sarreola07/VENATOR/drone/wildlife/README.md

# drone/wildlife/ — the two wildlife cameras

Animal and human detection for field work. Two cameras that cover for each
other: the OAK-D-S2 sees in daylight and measures distance, the CSI camera sees
in the dark.

| Camera | Sensor | Role |
|---|---|---|
| **Camera 1** — OAK-D-S2 | IMX378 + 2× OV9282 | Daytime detection with stereo depth. Inference runs on its own VPU. |
| **Camera 2** — IMX219-160 IR-CUT | IMX219 on CAM0 | 160° FOV, colour by day, black and white at night, IR-sensitive. |

This is separate from [`../camera_publisher.py`](../README.md), the flight
person-tracker. That one stays on depthai 2.32 in
`~/oak_drone_project/depthai-env`; the wildlife code here uses depthai 3.10 in
`~/oak-venv`. The two APIs are incompatible, so keep the interpreters straight.

| File | What it is |
|---|---|
| `imx219_feed.py` | Camera 2. Live window or numpy frames, with day/night switching and the 180° invert. No OpenCV needed. |
| `ircut.py` | Day/night control of the IR-CUT optical filter over GPIO. |
| `imx219_camera.sh` | Launcher used by the desktop icon: `720p`, `1080p`, `day`, `night`, `snapshot`. Refuses to open a second capture. |
| `oak_camera.sh` | Launcher for camera 1: `detect`, `gui`, `info`, `test`, `images`, `classes`, `status`. Refuses to start if something else owns the OAK. |
| `oak_wildlife.py` | Camera 1. Spatial animal/person detection with a distance per hit; saves annotated evidence frames. Runs MegaDetector V6. |
| `tracking.py` | Per-object history from tracker ids: dwell, voted class, metric displacement. The detector had no memory before this. |
| `classes.py` | What gets reported and the confidence each class needs. One table shared by the live detector, the offline harness and the GUI, so they cannot disagree. |
| `gui_server.py` | Operator GUI for a phone, on `:8080`. The OAK encodes MJPEG itself and this relays the bytes undecoded — the Jetson has no hardware video encoder. See [../../docs/OPERATOR_GUI.md](../../docs/OPERATOR_GUI.md). |
| `gui_page.py` | The GUI's single page. Dark, red/amber, boxes drawn client-side on a canvas. |
| `vest.py` | The vest search: finds the person in the target colour and ignores everyone else. See [Vest search](#vest-search). |
| `vest_calibrate.py` | Teaches the vest search what the vests look like in this room. |
| `webcam_search.py` | The vest search on a Mac's webcam, with Apple's person detector and no depth. A proof of concept, not the flight path. |
| `oak_info.py` | Identifies the OAK, its fitted sensors and whether it has IR illumination. |
| `oak_test.py` | Proves the OAK streams colour and stereo depth. |
| `test_detector.py` | Runs the detector over image files, so you can check what it sees before flying it. |
| `setup_cam0.sh` | One-time device-tree overlay enable for CAM0. Needs sudo; dry-run by default. |
| `oak_daynight.py` | Live view that switches itself between colour and mono from what auto-exposure is doing. |
| `oak_night.py` | Mono-only night view (both sensors side by side, for comparison). |
| `lib_pid.sh` | Shared process lookup. `pgrep -f` alone matches shells that merely mention a script name. |
| `oak_ir_test.py` | Does this OAK see infrared? Locks exposure and compares all three sensors. |
| `checks/` | `check_camera.sh` (8-point camera health), `system_check.sh` (whole box, incl. the 7 W guard), `diagnose.sh` (GUI wrapper). |
| `config/` | Known-good boot config and checksums — see [Recovery](#recovery). |

## Everyday commands

Each camera has one executable; neither needs you to remember which interpreter
to use.

```bash
# camera 2 — CSI
./drone/wildlife/imx219_camera.sh            # feed, auto day/night
./drone/wildlife/imx219_camera.sh night      # force black and white
./drone/wildlife/imx219_camera.sh snapshot   # full-res still into ~/Pictures

# camera 1 — OAK-D
./drone/wildlife/oak_camera.sh               # detect, with distance
./drone/wildlife/oak_camera.sh gui           # operator GUI for a phone, :8080
./drone/wildlife/oak_camera.sh view          # live view, auto colour/mono
./drone/wildlife/oak_camera.sh day|night     # force one mode
./drone/wildlife/oak_camera.sh calibrate     # AE readings, to tune thresholds
./drone/wildlife/oak_camera.sh info          # what OAK is this?
./drone/wildlife/oak_camera.sh status        # who currently owns the device?
./drone/wildlife/oak_camera.sh images ~/Pictures/testset/   # test on photos

# health
./drone/wildlife/checks/check_camera.sh      # is camera 2 healthy?
./drone/wildlife/checks/system_check.sh      # is anything else wrong?
```

Desktop icons for both are installed by `bash deploy/install_shortcuts.sh`:
**Wildlife Camera (IMX219)** and **Wildlife Detector (OAK-D)**. Right-click
either for day/night, snapshot, device info and health actions.

The OAK allows exactly one host process, and the flight person-tracker wants it
too. `oak_camera.sh` checks first and tells you who has it, rather than failing
with a device error twenty seconds in.

## Day and night

| | Colour | ISP saturation | IR-CUT filter |
|---|---|---|---|
| **day** | normal colour | 1.0 | ON — blocks IR |
| **night** | black and white | 0.0 | OFF — IR passes |

Both are hardware paths. `saturation` is an `nvarguscamerasrc` property applied
inside the ISP, so greyscale is free — no GRAY8 conversion, no CPU
`videobalance`. The 180° invert is `nvvidconv flip-method=2`, which runs on the
VIC. Measured cost of all of it: **55 fps at 640×360**, slightly *faster* than
before the flip and metering branch were added.

Greyscale at night is not cosmetic. With the IR-CUT filter removed the Bayer
colour filters see infrared, producing a heavy magenta cast that carries no real
colour information. Dropping chroma gives a cleaner image that compresses better.

### Switching is on a clock, not on the image

`--daynight schedule` is the default: sunrise/sunset at `--lat`/`--lon`
(defaults to Austin), using −6° civil twilight. It cannot be fooled by
auto-exposure, headlights, or a camera pointed at the ground.

`--daynight auto` (metering the image) **does not work on this camera** and is
kept only for hand testing. Measured in a pitch-dark room:

```
meter mean = 101.5      night threshold was 40
```

Argus auto-exposure raises analog gain up to 10.6× until the scene averages to
a "correct" exposure, so mean luma sits near mid-grey however dark it really is.
No threshold separates day from night through AE — raising it above 101 would
just report night at midday.

### Night mode needs an IR light source

Removing the IR-CUT filter makes the sensor **able to see** infrared. It does
not **produce** infrared. In a dark room with no IR source, an IR-sensitive
camera sees exactly what a normal one does: nothing. Measured:

| Mode | mean luma | std dev | JPEG |
|---|---|---|---|
| day (colour) | 37.6 | 0.5 | 4 KB |
| night (B&W) | 36.6 | 0.5 | 4 KB |

Identical blank frames — a std of 0.5/255 is amplified sensor noise, not an
image. The Waveshare kit's **IR illuminator boards must be connected to the
3.3 V pads** on the camera PCB for night vision to mean anything. IR is
invisible; point a phone camera at them to confirm they are lit.

Those illuminators reach perhaps 5–10 m. That is fine for a fixed camera trap
and useless from a drone at altitude — see the thermal note in
[../../docs/WILDLIFE_CAMERA.md](../../docs/WILDLIFE_CAMERA.md).

### The IR-CUT filter needs one wire

The 22-pin CAM0 connector carries no spare GPIO, so the filter is switched from
the 40-pin header:

```
camera "IR-CUT" / IO pad  ->  40-pin BOARD pin 7
camera GND                ->  40-pin pin 6 (or 9/14/20/25/30/34/39)
```

3.3 V logic both ends. **Never drive that pad from a 5 V pin.** Without the wire
everything still runs — you get the colour/greyscale switch but not the optical
filter, and the feed prints one warning saying so.

The infrared **illuminator LEDs are not software-controllable at all**. They are
wired to the camera board's 3.3 V pads and lit whenever it has power; switching
them would need a MOSFET in that supply. IR is invisible — point a phone camera
at them to check.

## The 7 W budget is guarded, because it drifted once

`system_check.sh` verifies three separate things, not just the live mode:

| Check | Why |
|---|---|
| `nvpmodel` id == 1 | the mode right now |
| `PM_CONFIG DEFAULT=1` in `/etc/nvpmodel.conf` | what comes back after a reboot |
| `/var/lib/nvpmodel/status` == `pmode:0001` | the last explicit selection |

On 2026-09-28 the rig silently came back at **15 W** after a reboot because the
config still carried `DEFAULT=0`. The live mode alone would not have caught it
in advance, and nothing flagged it — the only clue was "15W" in the GNOME top
bar. If a check ever fires:

```bash
sudo nvpmodel -m 1
sudo sed -i 's/PM_CONFIG DEFAULT=0/PM_CONFIG DEFAULT=1/' /etc/nvpmodel.conf
```

## Camera 1 day/night: read auto-exposure, not brightness

`oak_daynight.py` switches between the colour sensor and the mono sensor by
reading what auto-exposure **chose**, not how bright the picture looks.

Measuring brightness does not work. AE drives every scene toward mid-grey, so a
blacked-out room and a lit one report nearly the same mean — on the CSI camera
the meter read 101/255 in the dark against a "night" threshold of 40. Reading
AE's own settings sidesteps that entirely, because it measures how much light
actually arrived.

Measured on this unit in a dark room:

| Sensor | exposure | ISO | AE load |
|---|---|---|---|
| CAM_A colour | 30008 µs (max) | 1599 (max) | **1.00 — given up** |
| CAM_B mono | 29992 µs (max) | 424 | 0.27 |

AE load is `exposure × ISO` as a fraction of the sensor's ceiling. Above
`--night-load` (0.80) it switches to mono; below `--day-load` (0.45) back to
colour. Two guards stop it flapping:

- **`--settle 3`** — ignore the first seconds entirely. AE has not converged,
  and the garbage readings flipped the mode three times in two seconds.
- **`--dwell 3`** — the threshold must hold continuously before acting, so a
  drone panning across the sky or a passing headlight cannot trigger a switch.

Both sensors stream the whole time; switching picks which frame to draw, so the
change is instant and CAM_A keeps working as the light meter even while mono is
on screen. Run `oak_camera.sh calibrate` to pick thresholds for your own site.

## Night vision, measured

The OAK's mono pair is the real low-light sensor on this rig. Same dark room,
same night:

| Camera | mean | std dev | result |
|---|---|---|---|
| IMX219 (CSI) | 37.6 | 0.5 | blank field |
| **OAK OV9282 mono** | 116 | **15.6** | **usable image at 30 fps** |

At an identical locked exposure the monos read **132 against the colour
camera's 22** — no Bayer filter discarding two thirds of the light, plus
OmniVision's "best-in-class NIR QE". `oak_night.py` is that view.

The colour IMX378 carries an IR-cut filter and the monos, on the evidence of
the OAK-D-PRO illuminating these same sensors at 940 nm, do not — so the mono
pair should also see an 850 nm laser. `oak_ir_test.py` settles it with a TV
remote. Note the S2 has **no IR emitters** (`getIrDrivers() == []`): it is a
passive sensor and still needs some light.

## Vest search

The search-and-rescue simulation: a missing person was last seen in a yellow
construction vest.
The camera service marks that person TARGET and everyone else ignored, shows a
confidence chart on the phone page, and sends a report over loopback UDP for the
flight code to read.

This is a bench test, with the props off. **Nothing here commands the aircraft
yet.** The flight side is not built. It needs the ARK Flow hover working first.

To set it all up with Claude Code on the Jetson, paste the master prompt in
[docs/YELLOW_VEST_PROMPT.md](../../docs/YELLOW_VEST_PROMPT.md).

### From the operator's page

Everything is on the page the normal `venator-gui` service already serves, so
there is nothing to stop or restart. Open it with the GUI token (the address
`bash deploy/field_mode.sh url` prints). The **Vest search** row is only on that
page: view-only phones never see it, and the server refuses their writes anyway.

1. **Turn it on:** press **yellow** for the construction vest, or **red** or
   **blue** to show the colour isn't built in. The camera restarts for a few
   seconds, because only the search pulls colour frames over USB (about
   35 Mbps). Switching colour after that is instant. **off** stops it.
2. **Calibrate, once per room:** with the search on, press **calibrate yellow**,
   and hold the yellow vest about 1 m away, filling the middle of the view, for
   a second. The silver reflective tape doesn't matter, because grey and white
   are left out of the fit, but most of the middle should be the yellow fabric.
   The page says what it learned, or warns if two vests now overlap. Do the
   decoys' vests too. It's saved to `~/.venator/vest-colours.json` and used
   straight away.
3. **Record trials:** type a note, such as `4 m, daylight, Sam in yellow`, press
   **record**, run the trial, and press **stop**. Each one is a CSV in
   `<save dir>/trials/`, and the links under the row download them. One row per
   person per frame, and one for each FOUND.

While a search is on, phones joining the hotspot are handed the view-only token,
so turn it on before the audience joins. `bash deploy/symposium_qr.sh` prints the
view-only address as a QR code.

White balance can only be locked from the terminal tool, because measuring it
needs camera controls the service doesn't open:

```bash
sudo systemctl stop venator-gui
~/oak-venv/bin/python drone/wildlife/vest_calibrate.py
sudo systemctl start venator-gui
```

`gui_server.py --search` still starts with the search on, for running by hand. On
its own it looks for yellow; name a colour (`--search blue`) for another.
The flight code can also set the colour over loopback:

```bash
python3 -c "import socket, json; socket.socket(socket.AF_INET, socket.SOCK_DGRAM).sendto(json.dumps({'target': 'blue'}).encode(), ('127.0.0.1', 5008))"
```

### The chart

The chart plots **vest match** (how much of the chest is the target colour, with
a lock possible above the match line) or **person** (the detector's confidence).
**snapshot** keeps the chart and readings on that phone, **save PNG** downloads
that chart, and **save CSV** downloads the readings for the results table. Nothing
is sent back to the drone.

For a printed poster, press **poster** first. The chart turns white and large, and
a snapshot then saves as 3000 x 1500 pixels (10 x 5 inches at 300 pixels per inch),
with what it measured, the detector and the time printed on it. It plots the last
30 seconds of people only, and it is off every time the page opens, because the
rest of this page stays dark for night use.

Bright clothes in the target colour will fool it: it matches a description, and
a yellow shirt looks the same as a yellow vest. Hi-vis "yellow" is really a
fluorescent yellow-green, so the built-in yellow runs from 40 to 90 degrees of
hue to take in every vest the ANSI standard allows, and olive and lime clothes
fall inside that too. An orange hi-vis vest is not taken for the yellow one.
Calibrate yellow with the real vest in the room you test in, and the range
narrows to that vest.

### On a Mac's webcam, with no camera hardware

`webcam_search.py` runs the same colour check, vote, page, chart and snapshots on
the built-in webcam. See its header for the install line. It uses Apple's person
detector rather than MegaDetector, and it has no depth, so it shows no distances
and proves nothing about the 2 m safety rule. Run it from Terminal the first time:
macOS only asks for camera access on behalf of an app that can show the prompt.
Stand back far enough that your chest is in frame: at a desk, the part of the box
it reads as the chest lands on your face.

### On a laptop, before the Jetson

The person detector runs on the camera's own chip, so the same test works with
the OAK plugged into a Mac. Only speed, temperature and USB load in the Jetson's
7 W mode still have to be measured on the Jetson.

```bash
python3 -m venv ~/oak-venv
~/oak-venv/bin/pip install depthai==3.10.0 numpy
~/oak-venv/bin/python drone/wildlife/oak_info.py
~/oak-venv/bin/python drone/wildlife/vest_calibrate.py
~/oak-venv/bin/python drone/wildlife/gui_server.py --search --save-dir ~/Pictures/venator-search
```

Then open <http://127.0.0.1:8080>. The first run downloads the detector, about
4 MB, and needs internet. With no key file the page is only reachable from the
laptop itself, which is what you want for this test. With no camera attached,
Ctrl+C can take about 10 seconds, because it waits for the device search to end.

## Recovery

`config/STATE.txt` holds the verified device-tree values and SHA-256 sums of the
boot DTB and overlay. If the camera ever stops working, `sha256sum` against it
says in one command whether the boot files changed or whether it is hardware.

Full hardware setup, performance numbers, model choice and troubleshooting:
[../../docs/WILDLIFE_CAMERA.md](../../docs/WILDLIFE_CAMERA.md).
