sarreola07/VENATOR/assets/brand/png/social-preview-1280.png

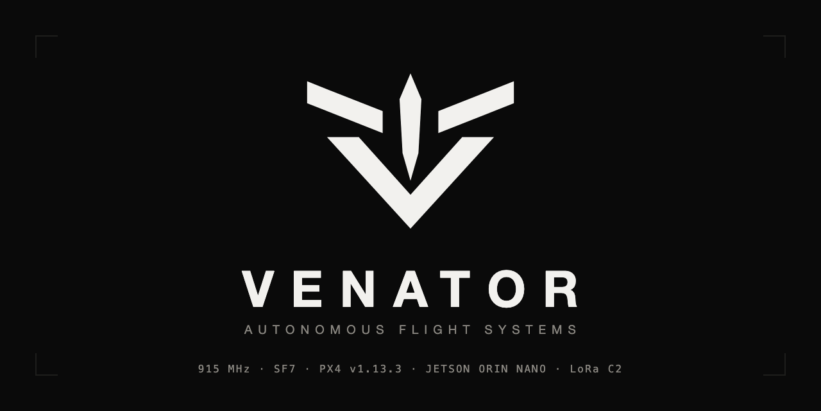
assets/brand/png/social-preview-1280.png
