sarreola07/VENATOR/assets/brand/png/venator-lockup-dark-1600.png

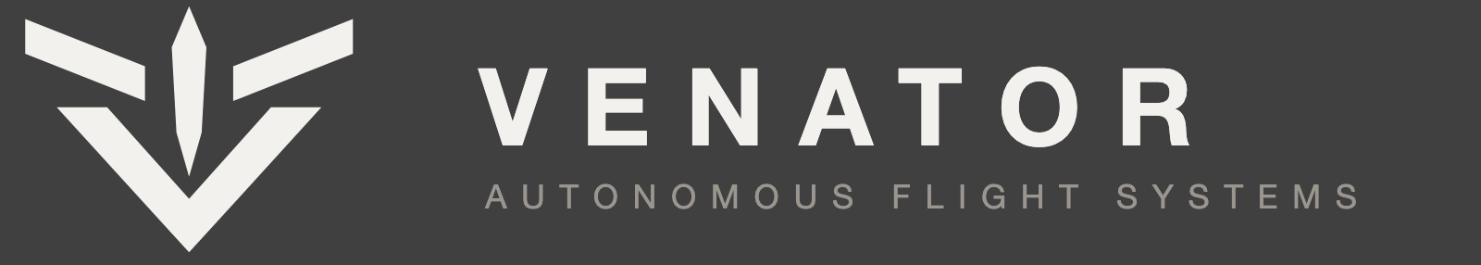
assets/brand/png/venator-lockup-dark-1600.png
