sarreola07/VENATOR/assets/brand/png/venator-lockup-light-1600.png

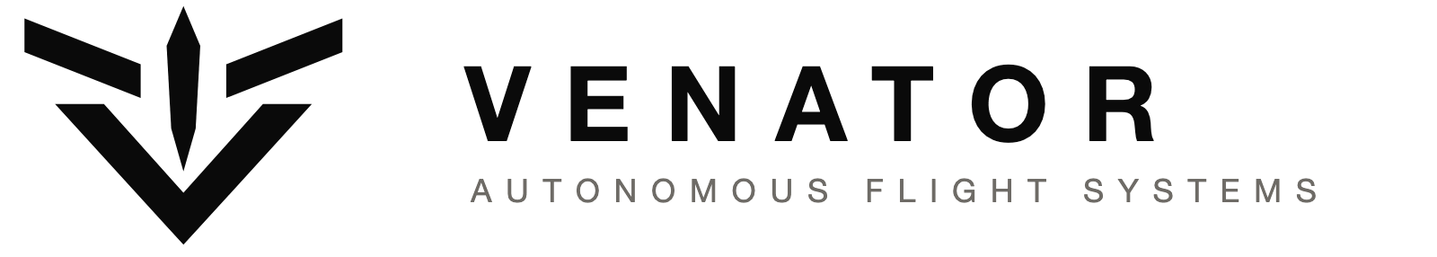
assets/brand/png/venator-lockup-light-1600.png
