sarreola07/VENATOR/assets/brand/png/venator-lockup-stacked-dark-1200.png

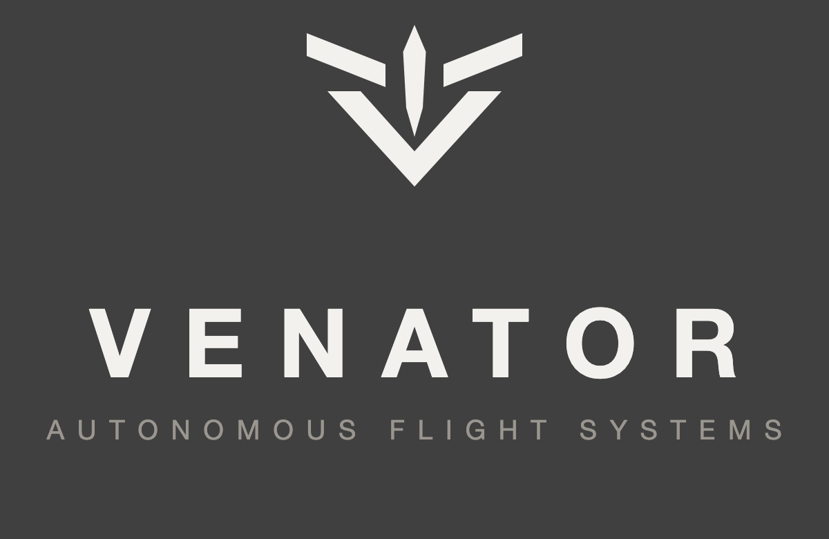
assets/brand/png/venator-lockup-stacked-dark-1200.png
