sarreola07/VENATOR/assets/brand/png/venator-lockup-stacked-dark-2400.png

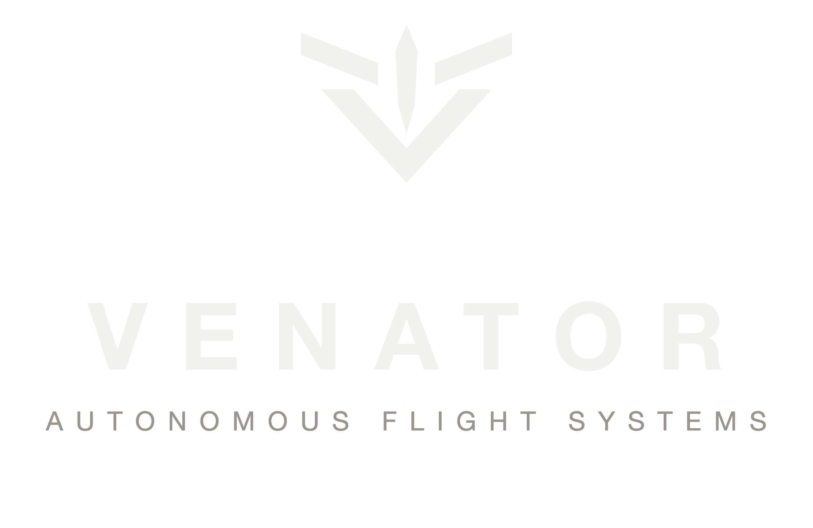
assets/brand/png/venator-lockup-stacked-dark-2400.png
