sarreola07/VENATOR/assets/brand/png/venator-mark-dark-512.png

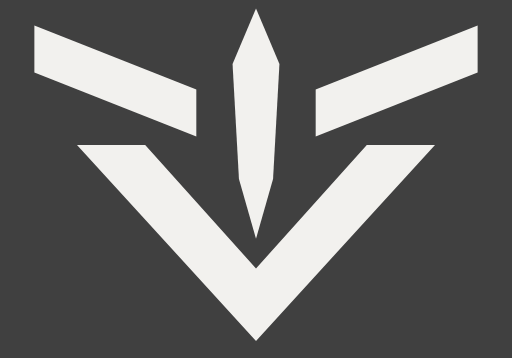
assets/brand/png/venator-mark-dark-512.png
