sarreola07/VENATOR/assets/brand/png/venator-mark-light-512.png

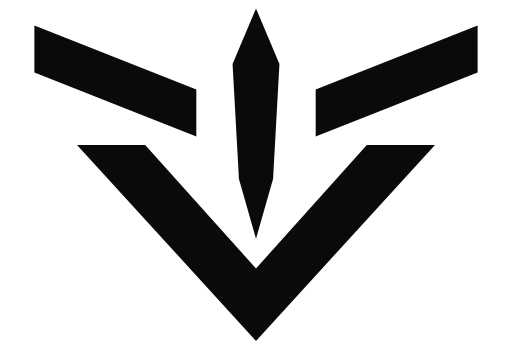
assets/brand/png/venator-mark-light-512.png
