sarreola07/VENATOR/assets/cine/lg/f000.webp

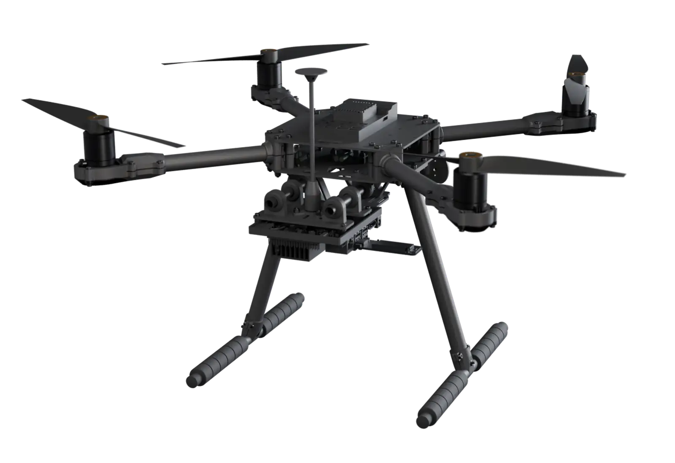
assets/cine/lg/f000.webp
