sarreola07/VENATOR/assets/cine/lg/f018.webp

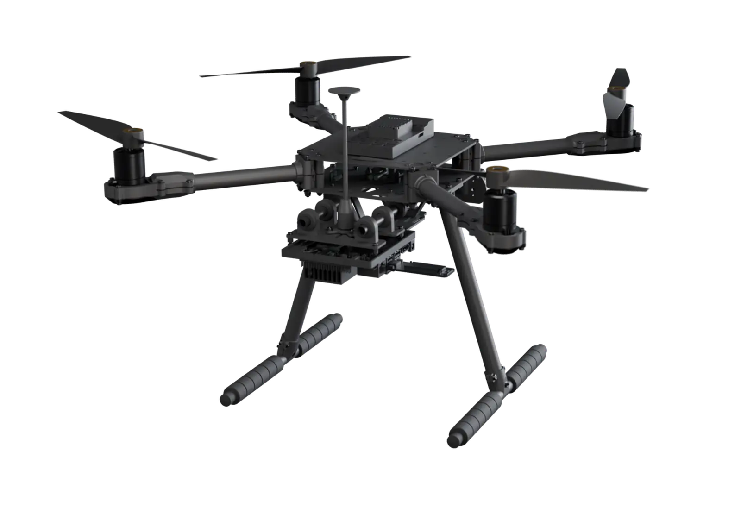
assets/cine/lg/f018.webp
