sarreola07/VENATOR/assets/cine/lg/f025.webp

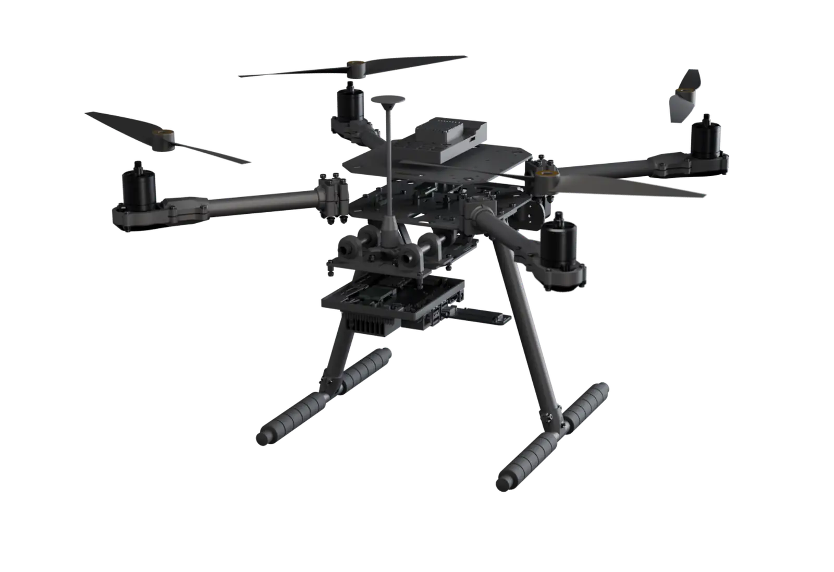
assets/cine/lg/f025.webp
