sarreola07/VENATOR/assets/cine/lg/f033.webp

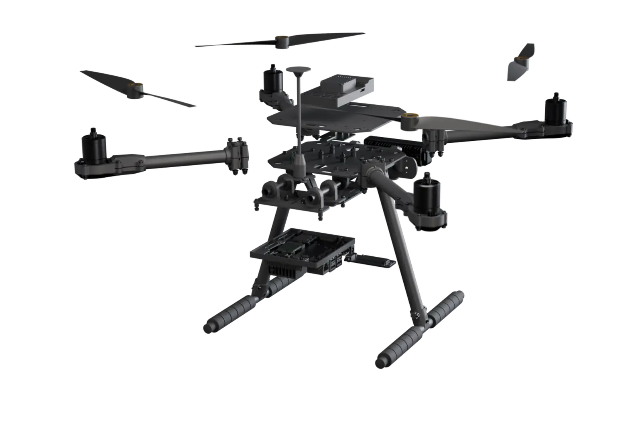
assets/cine/lg/f033.webp
