sarreola07/VENATOR/assets/cine/lg/f045.webp

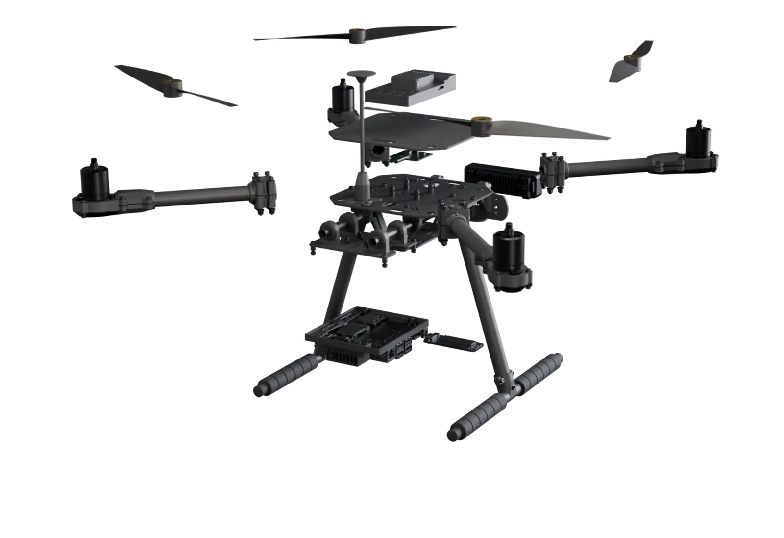
assets/cine/lg/f045.webp
