sarreola07/VENATOR/assets/cine/lg/f053.webp

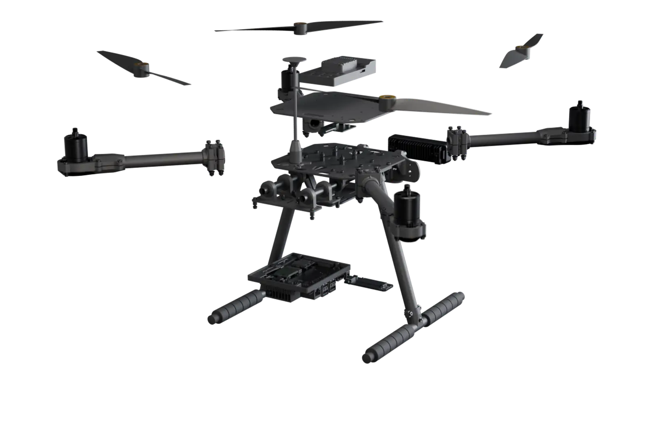
assets/cine/lg/f053.webp
