sarreola07/VENATOR/assets/cine/lg/f084.webp

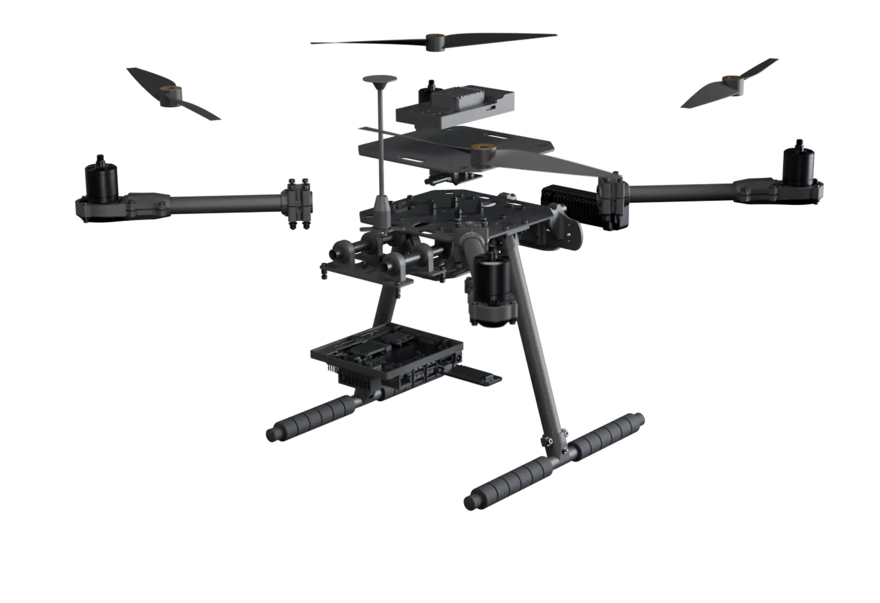
assets/cine/lg/f084.webp
