sarreola07/VENATOR/assets/cine/lg/f091.webp

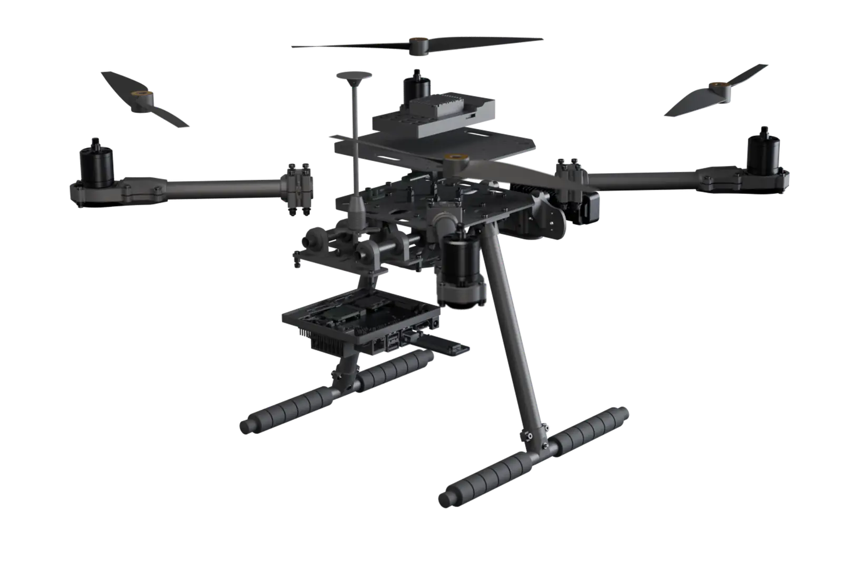
assets/cine/lg/f091.webp
