sarreola07/VENATOR/assets/cine/lg/f101.webp

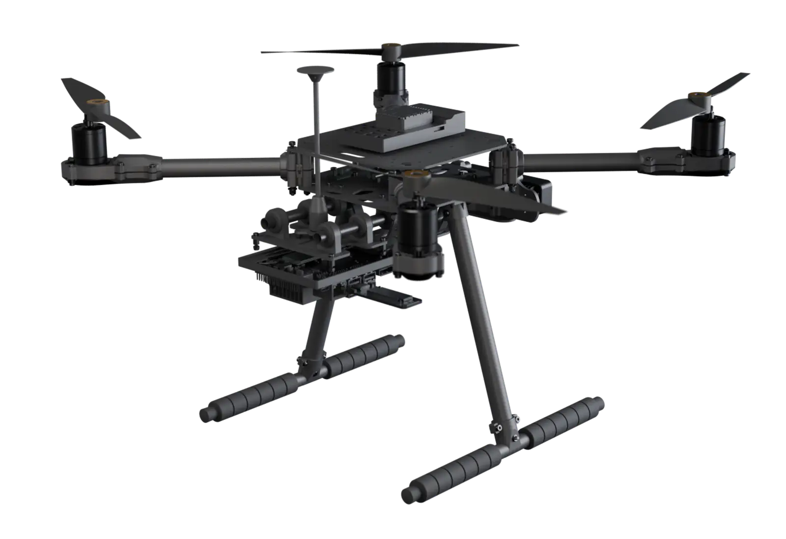
assets/cine/lg/f101.webp
