sarreola07/VENATOR/assets/cine/lg/f108.webp

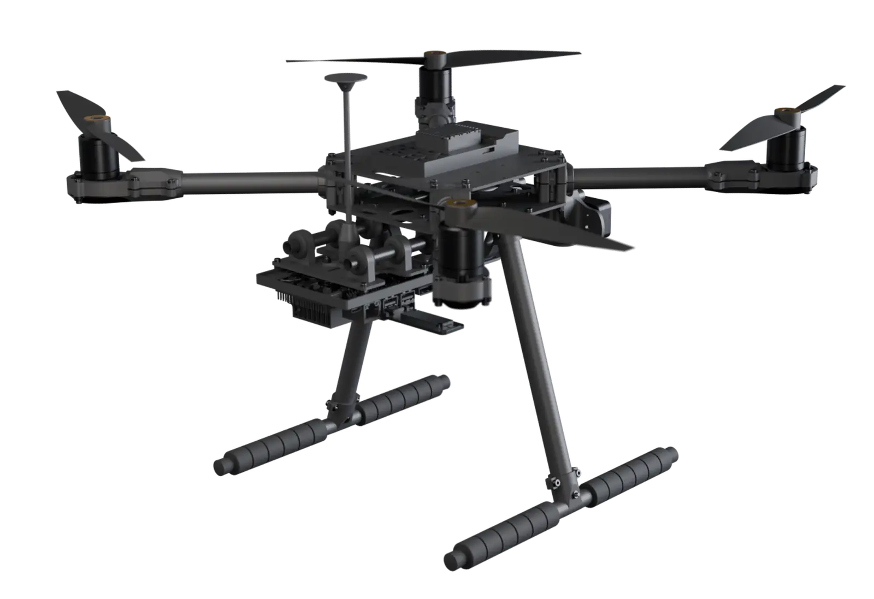
assets/cine/lg/f108.webp
