sarreola07/VENATOR/assets/renders/cu-arm.webp

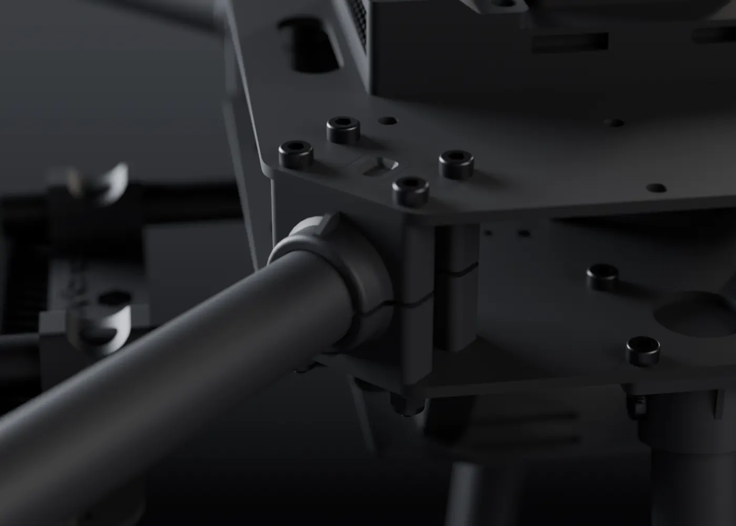
assets/renders/cu-arm.webp
