sarreola07/VENATOR/assets/renders/cu-gps.webp

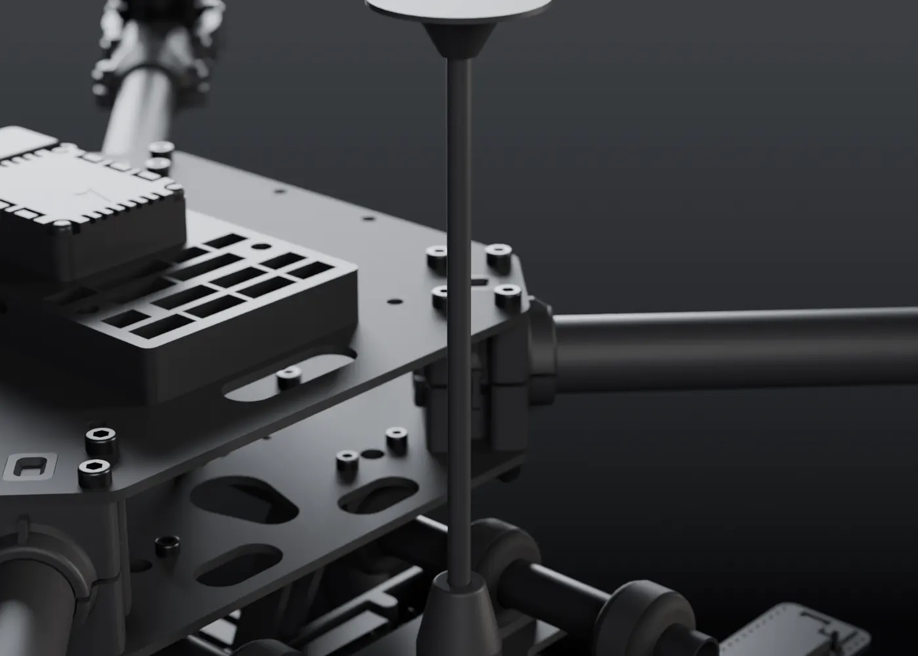
assets/renders/cu-gps.webp
