sarreola07/VENATOR/assets/renders/cu-jetson.webp

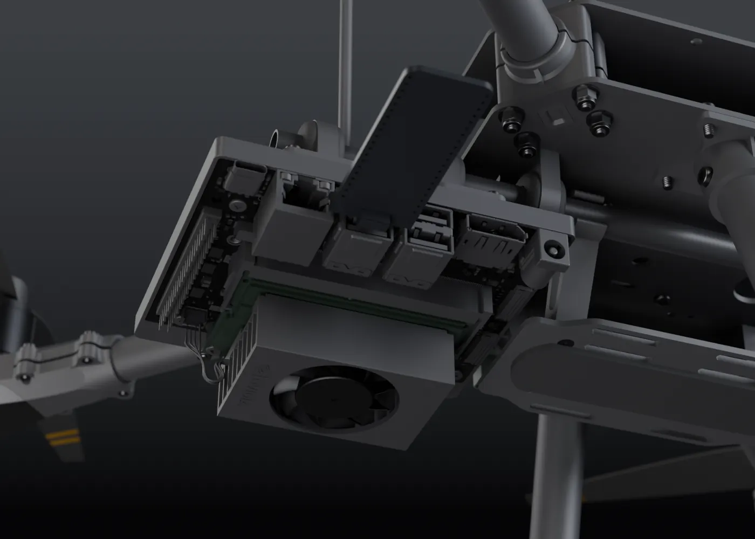
assets/renders/cu-jetson.webp
