sarreola07/VENATOR/assets/renders/cu-motor.webp

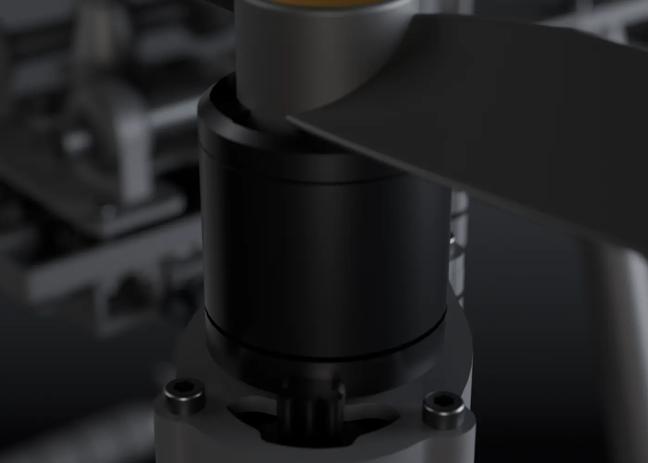
assets/renders/cu-motor.webp
