sarreola07/VENATOR/assets/renders/cu-oakd.webp

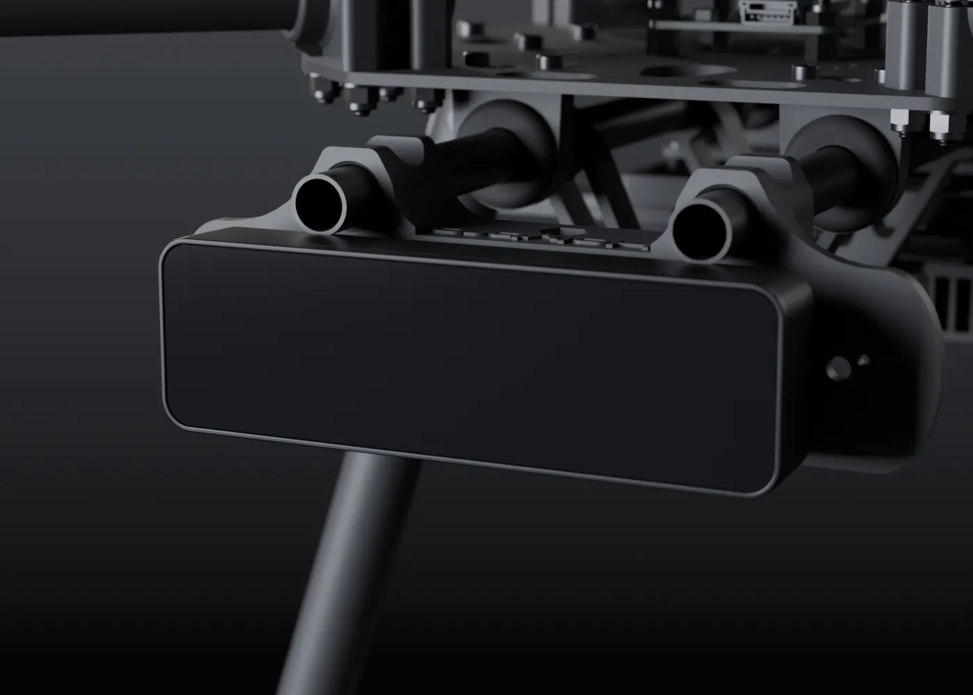
assets/renders/cu-oakd.webp
