sarreola07/VENATOR/assets/renders/cu-pixhawk.webp

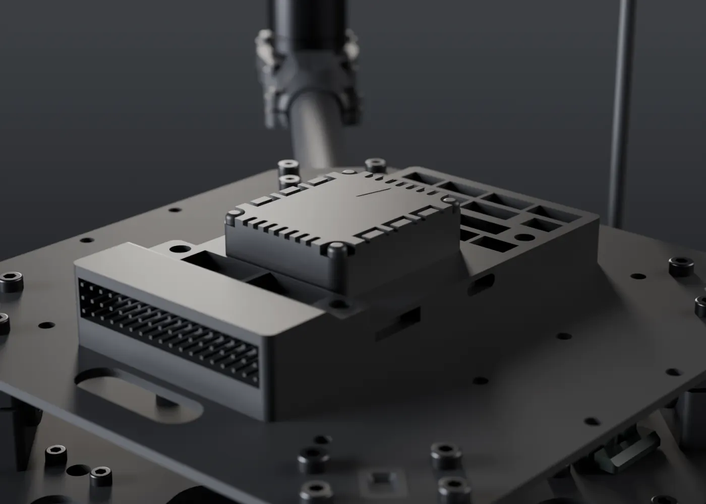
assets/renders/cu-pixhawk.webp
