sarreola07/VENATOR/assets/renders/three-q-full.webp

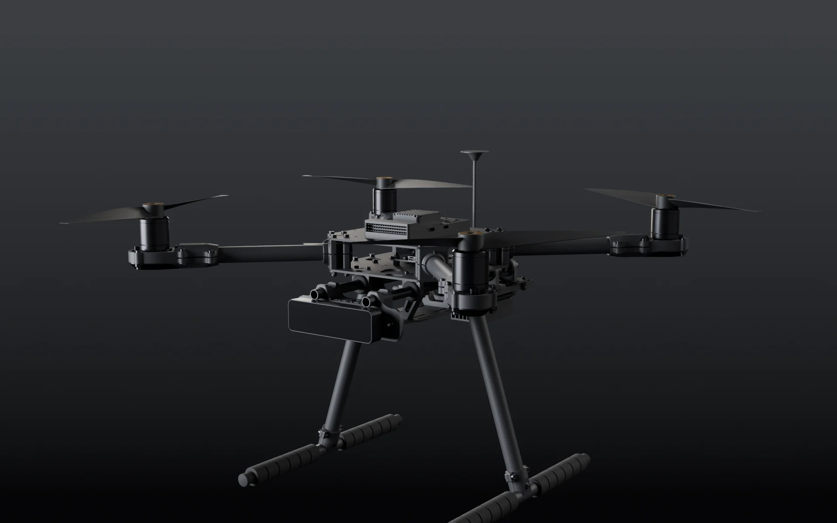
assets/renders/three-q-full.webp
