sarreola07/VENATOR/assets/renders/view-front-full.webp

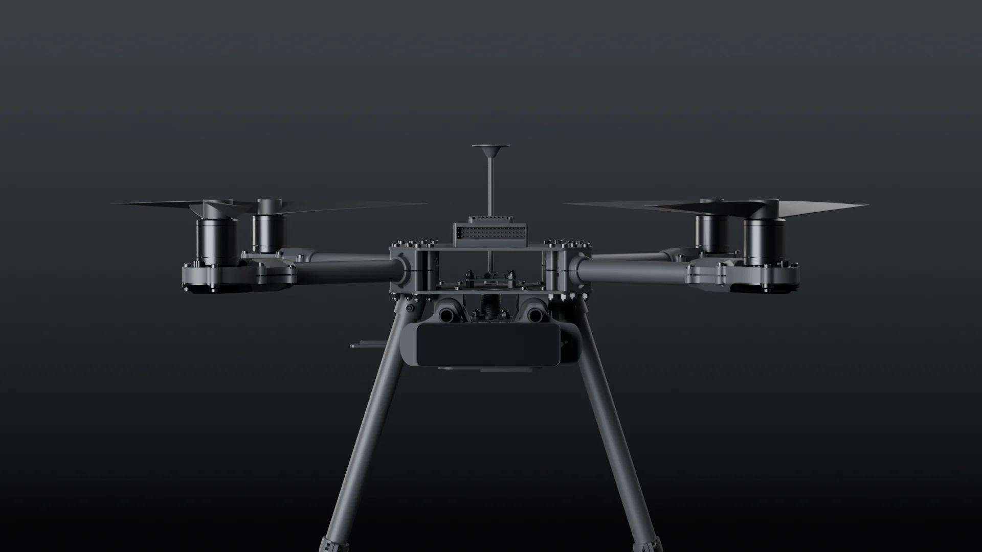
assets/renders/view-front-full.webp
