sarreola07/VENATOR/assets/renders/view-side-full.webp

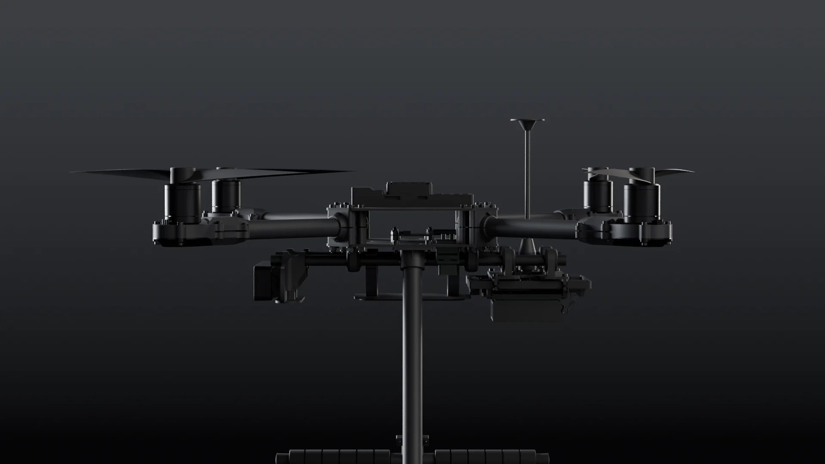
assets/renders/view-side-full.webp
