sarreola07/VENATOR/assets/renders/view-top-full.webp

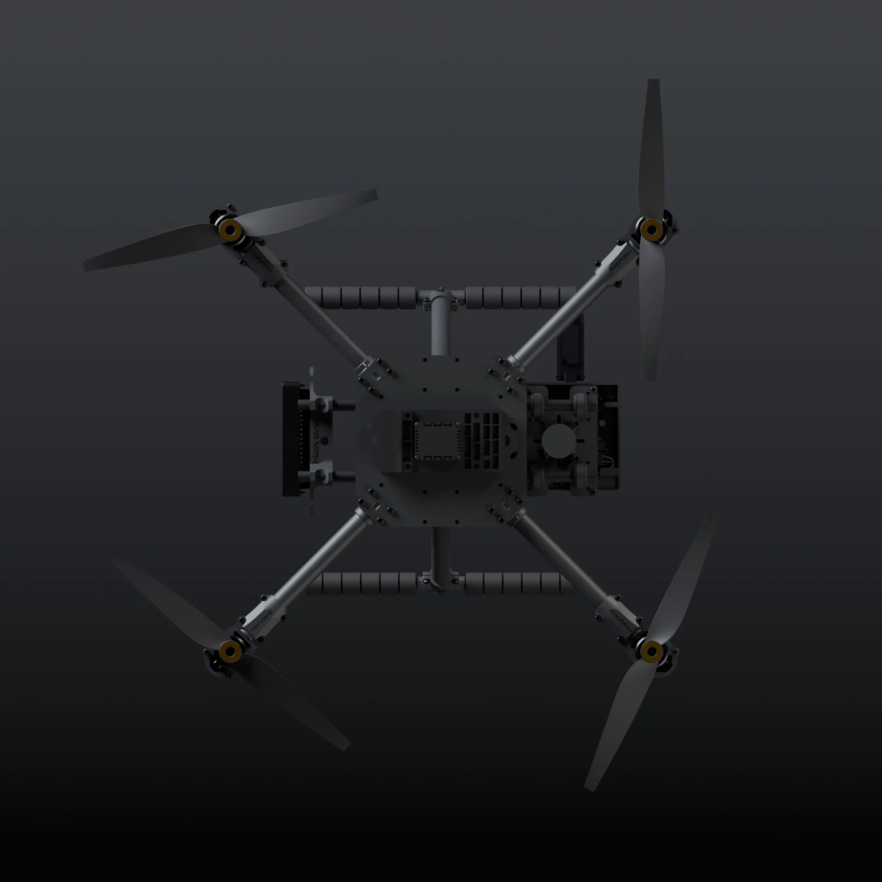
assets/renders/view-top-full.webp
