sarreola07/VENATOR/assets/social-card.jpg

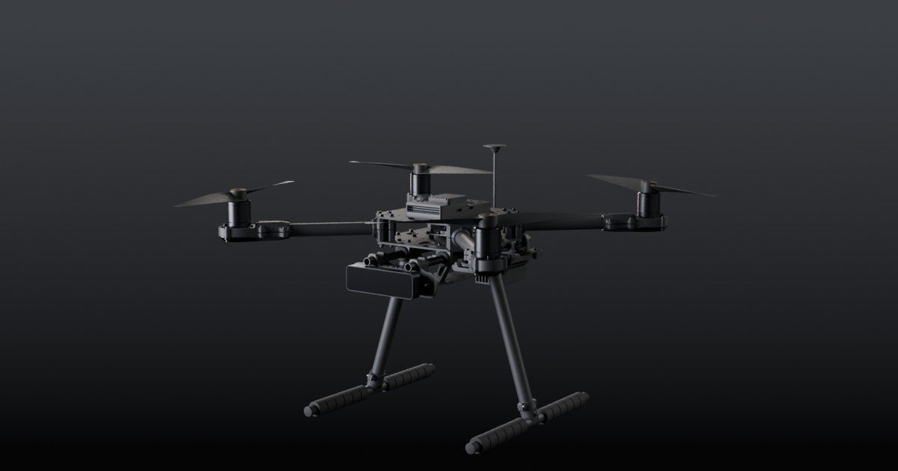
assets/social-card.jpg
