sarreola07/VENATOR/docs/img/venator-qr-dashboard.png

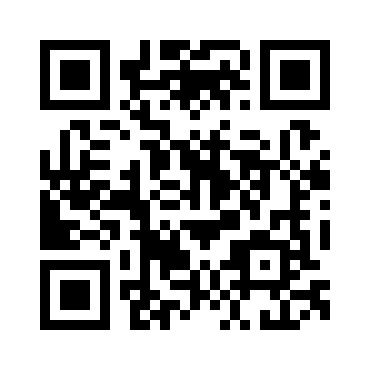
docs/img/venator-qr-dashboard.png
