sarreola07/VENATOR/(list of files, cad)

Other CAD files:
blender/x500_cad.blend
