sarreola07/VENATOR/(commit log)

2026-07-22 Phase 4: Jetson C2 server (drone side of the LoRa link)
    - jetson_c2_server.py: reads C2 protocol from the LoRa serial, serves the menu,
    runs missions on the Pixhawk (reusing missions.py), ACKs back. Mock FC + props
    OFF by default (safe); --real connects the Pixhawk, --props-on enables flight.
    Props and GPS safety gates enforced server-side.
    - systemd/venator-c2.service: zero-touch boot unit (enable deliberately).
    - Tested: real gcs_client <-> real C2 server over a loopback — handshake, menu,
    motor test accepted, flight correctly rejected (props/GPS gates), waypoint
    upload. Verified both props states.
    - docs/ROADMAP.md updated.
    [jetson_c2_server.py]
2026-07-22 Fix: compact menu so it fits one LoRa packet (was 284B > 240B buffer)
    The full menu (with needs/gps fields) exceeded the firmware's 240-byte line
    buffer and LoRa's 255-byte limit, so it was truncated mid-JSON and the client
    couldn't parse it ('drone sent no menu'). Send an id+name list (184B); the
    server keeps the full menu internally for the props/GPS safety gates.
    [jetson_c2_server.py]
2026-07-22 Rich menu (per-item streaming) + boot-service polish
    - Menu is streamed one item per LoRa packet (each ~100 B, fits), so the props/GPS
    flags are back and the menu can grow to any size. Client collects until 'last'.
    - jetson_c2_server: line-buffered stdout (journald), exclusive LoRa port.
    - install_boot_service.sh: installs venator-c2.service so the Jetson starts the
    C2 link on boot (zero-touch). Nothing arms on boot; props OFF by default.
    - docs updated.
2026-07-23 Phase 5: real waypoint mission upload (bench-tested on the Pixhawk)
    RealFC.upload_waypoints now validates coords (lat/lon range, 0<alt<=50m), builds
    a takeoff -> NAV_WAYPOINTs -> RTL mission, and uploads it via the MAVLink mission
    protocol. Adds clear_mission().
    Bench-tested against the real FMUv2/PX4 1.13.3: 3-waypoint mission ACCEPTED and
    read back (5 items), bad coords rejected, mission cleared (FC left empty). Fixed
    a PX4 quirk found via probing: the RTL item needs MAV_FRAME_MISSION, not the
    global frame, or PX4 rejects the whole mission as UNSUPPORTED.
    Upload works without a GPS fix (PX4 just stores the plan). The arm+AUTO.MISSION
    flight trigger + two-step arm + link-loss RTL are the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
    [jetson_c2_server.py]
2026-07-24 Boot service: start early instead of waiting on multi-user.target
    snapd.seeded.service stalls multi-user.target ~2 min at boot, which delayed the
    C2 server by the same. Order after local-fs.target and rely on the existing retry
    (Restart=on-failure) to wait for the USB ports/Pixhawk — so the link is live
    within seconds of boot, not 2 minutes.
2026-07-24 Server: auto-detect the Pixhawk by stable by-id (survives replug/reflash)
    A USB replug moved the Pixhawk ttyACM0->ttyACM1 and broke the hardcoded path.
    Default --fc-device is now 'auto': prefer /dev/serial/by-id/*PX4*/*FMU* (stable
    across renumbering and the v2->v3 reflash), fall back to any /dev/ttyACM*.
    [jetson_c2_server.py]
2026-07-24 Flight trigger + safety: two-step arm, AUTO.MISSION, link-loss RTL
    - Protocol: FLY_REQ + CONFIRM (two-step arm); STATUS carries in-flight telemetry.
    - Server: FLY_REQ gates on props ON + GPS 3D fix + a mission being uploaded;
    CONFIRM triggers run_flight() which arms, switches to AUTO.MISSION, and monitors
    with a LINK-LOSS -> RTL failsafe (no client ping for LINK_LOSS_S -> return home)
    plus ABORT -> RTL, until landed & disarmed.
    - Client: upload -> two-step FLY/LAUNCH confirm -> live flight monitor (pings,
    status, Ctrl-C aborts to RTL).
    - MockFC gained a flight simulator; bench-tested: gates reject correctly, normal
    flight completes, and a mid-flight link loss correctly triggers RTL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
    [jetson_c2_server.py]
2026-07-24 Mission 1: hover + detect people + land
    Menu 'Mission 1' -> server prepares (validate props/GPS) -> two-step confirm ->
    run_mission1(): arm -> AUTO.TAKEOFF to HOVER_ALT_M -> hover HOVER_TIME_S while
    reading OAK-D person detections (UDP 5005) and reporting them over LoRa -> LAND
    in place -> disarm. Same link-loss RTL + abort failsafes as run_flight.
    Hover altitude defaults to a GPS-safe 2 m (not literal 3 ft — GPS vertical error
    makes 0.9 m unsafe without the downward lidar; one constant to change later).
    Bench-tested with mock FC + injected camera packets: phases takeoff->hover->land,
    person-detections counted and reported, and a mid-flight link loss triggers RTL.
    [jetson_c2_server.py]
2026-07-24 Mission 2: follow-me (OFFBOARD velocity), + unify flight pending-state
    - Mission 2: arm -> takeoff -> OFFBOARD, follow the OAK-D person keeping FOLLOW_DIST_M
    (bang-bang: forward/back on distance, yaw on horizontal offset), until the client
    sends STOP (land in place). No person in view -> hover (never drift). Same abort
    and link-loss -> RTL failsafes. Protocol: STOP (normal end) vs ABORT (emergency RTL).
    - Client: mission_2_flow + monitor_follow (Enter=STOP/land, Ctrl-C=abort/RTL).
    - Refactor: three per-flight booleans -> one self._pending ('waypoints'/'mission1'/
    'mission2') consumed by CONFIRM; run_flight/run_mission1/run_mission2 dispatched by it.
    Bench-tested (mock FC + injected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
    [jetson_c2_server.py]
2026-07-24 Server: survive a missing Pixhawk instead of crash-looping in silence
    With the Pixhawk USB unplugged, the --real service died on startup before ever
    opening the LoRa port, so the laptop's HELLO got no answer at all ('no response
    from Jetson'). Now the LoRa link opens FIRST and the server retries the Pixhawk
    forever, answering HELLO/PING/GET_MENU meanwhile with an explicit 'Pixhawk NOT
    connected — check its USB cable' so the operator sees the actual problem.
    [jetson_c2_server.py]
2026-07-24 Auto-detect the LoRa stick by stable by-id too (survives ttyUSB renumbering)
    The replug shuffled the CP2102 from ttyUSB0 to ttyUSB1 and the hardcoded port
    crash-looped the service. --lora-port now defaults to 'auto' (by-id CP2102 ->
    any ttyUSB), matching the FC auto-detect.
    [jetson_c2_server.py]
2026-07-24 Add flight_mode.sh: switch the C2 service between bench (props off) and flight (props on)
    The boot service runs --real without --props-on, so every flight mission was
    rejected with 'props are OFF'. flight_mode.sh on|off writes/removes a systemd
    drop-in adding --props-on and restarts the service, keeping props-off as the
    safe default and making flight enablement deliberate.
2026-07-24 Add check_rc.py: RC transmitter pre-flight check
    Read-only tool showing live stick values, RC link health, PX4 channel mapping
    (throttle/roll/pitch/yaw/mode/kill/arm switches), COM_ARM_WO_GPS, and a
    movement summary, so the transmitter can be verified before any flight.
2026-07-24 Add preflight_audit.py: read-only pre-flight health report
    Reports sensor health, compass registration/calibration/orientation, GPS fix,
    flight-mode switch assignments, kill switch, failsafe actions, and battery —
    the things that block or endanger a first flight.
    [preflight_audit.py]
2026-07-27 Props ON by default + runtime props toggle from the menu
    In flight testing the props are always fitted, and the operator can't edit flags
    or run sudo from the field — so the props-OFF default silently blocked every
    flight mission ('props are OFF'). Now:
    - props default to ON (--props-off for bench/motor-test sessions)
    - new menu item 6 'Toggle props state' flips it at runtime over LoRa, so the
    state is never an unreachable hardcoded flag (LoRa menu is numbers-only)
    - flight_mode.sh inverted to match (drop-in now writes --props-off)
    The interlock itself stays: with props ON motor tests are refused, which is the
    direction that matters (never spin fitted props by hand).
    [jetson_c2_server.py]
2026-07-27 Client: survive corrupted LoRa packets instead of crashing
    A damaged menu packet arrived with an 'id' but no 'name'; the client appended it
    blindly and then crashed rendering the menu (KeyError: 'name'), killing the app
    mid-field. LoRa is lossy, so:
    - get_menu accepts only well-formed items (int id + str name), de-dupes by id,
    sorts, and warns how many packets were dropped
    - menu rendering uses .get() throughout
    - mission dispatch wrapped: a failed exchange returns to the menu instead of
    ending the session
    - new 'r) Refresh menu' so a partial menu can be re-fetched; auto-refresh after
    the props toggle so labels update
2026-07-27 Fix root cause of corrupted LoRa menu + Mission 1 takeoff altitude
    Root cause of the client's 'KeyError: name' crash: the server wrote all 6 menu
    packets (681 B) to serial in ~60 ms, but the Heltec firmware is half-duplex with
    a ~256 B UART buffer and needs ~1.2 s of airtime. The buffer overflowed, bytes
    were lost, and two JSON lines spliced into an item with an id but no name.
    - LoRaLink.send now paces every packet (0.3 s gap) and flushes
    - menu items strip server-internal keys ('fly'/'action') to cut airtime
    Also fixed before first flight:
    - Mission 1/2 never set MIS_TAKEOFF_ALT, so AUTO.TAKEOFF climbed to PX4's own
    default instead of HOVER_ALT_M. Added set_takeoff_alt() on both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
    [jetson_c2_server.py]
2026-07-27 Relay PX4's arm-refusal reason + add field diagnostics menu item
    With no monitor at the drone, 'FAILED: arm rejected' was undiagnosable. Now
    RealFC.arm() captures PX4's STATUSTEXT and COMMAND_ACK result and all three
    flight paths relay it ('PX4 refused to arm: PreArm: ...').
    New menu item 7 'Drone status' returns GPS fix/sats, battery voltage (or n/a when
    unmeasured), and any unhealthy sensors in one 77-byte packet, so readiness can be
    checked from the laptop alone. Docstring corrected for the props-ON default.
    [jetson_c2_server.py]
2026-09-16 Add camera web stream for laptop browsers + wifi_mode.sh hotspot switch
    School Wi-Fi blocks laptop-to-Jetson connections, so the camera could only be
    watched on a monitor plugged into the Jetson.
    Web stream: camera_publisher.py --stream serves a page on port 8080 with the
    live OAK-D view (person box + X/Y/Z readout) that any Windows/Mac browser can
    open. `./ai_camera.sh stream` starts it and prints the addresses; status lists
    them and restart keeps the stream on. start/toggle/preview are unchanged.
    - frames are only pulled from the camera while a page is open, and JPEG
    encoding runs on its own thread after the UDP send, so the coordinates the
    missions fly on are not delayed (UDP r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
2026-09-17 Add scripted two-ended link test + two-machine dev guide
    Developing the C2 link means running one end on each of two computers, but the
    only two-ended check we had was firmware/README's "open two serial monitors and
    type a line" — it needs a human at each keyboard and leaves you judging what
    scrolled past.
    link_test.py does the same check from the command line: --listen answers
    PING/HELLO, --send measures round-trip time and packet loss and exits 0/1 on a
    loss threshold, --chat carries typed lines both ways, --list names the ports.
    It speaks the real newline-JSON protocol via c2_protocol, so a pass proves the
    actual link rather than a special case. Stdlib + pyserial only, so it runs
    uncha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
2026-09-17 Make the bench path work on a non-Jetson Linux box and on macOS
    Follow-up to the link test: developing the two ends on two machines means the
    server runs on a stand-in for the Jetson before the real one is in the loop, and
    three things blocked that.
    setup.sh aborted before creating the venv on any machine with no flight
    controller attached. Under `set -e`, `chmod a+rw /dev/ttyACM0` against a missing
    device is fatal, so a bench box or a ground station could not get through setup
    at all. Grant access per device that actually exists, covering the LoRa stick
    (/dev/ttyUSB*) as well as the Pixhawk.
    find_lora_device() only knew /dev/serial/by-id/ and /dev/ttyUSB*, so on macOS or
    Windows `--lora-p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
    [jetson_c2_server.py, link_test.py]
2026-09-17 Show link health on the sticks' OLED
    Until now the only way to know whether the LoRa link was alive was to run
    software on a computer attached to a stick. At the field that is the wrong
    place to learn the radio is dead.
    The transceiver sketch now drives the V3's onboard 128x64 panel with packet
    counts, RSSI/SNR, seconds since the last packet, and the first 21 characters of
    the last line received. The signal figures cost nothing to collect: onRxDone
    already received rssi and snr from the radio and discarded them.
    Drawing is throttled to 4 Hz and skipped while a transmit is in flight -- a
    full frame is ~20-30 ms of blocking I2C, and stalling Radio.IrqProcess() would
    drop packets. The radio i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
    [LoRa_Transceiver.ino]
2026-09-17 Fix the OLED for the Wireless Stick V3's 64x32 panel
    The sticks are Heltec Wireless Stick V3 boards, not WiFi LoRa 32 V3. The two
    board definitions share every pin this sketch uses (SX1262, OLED I2C, Vext),
    so a build for the wrong board still boots and passes the link test. But the
    sketch drove the 0.49" 64x32 panel as 128x64, and that panel only shows a
    64x32 window from the middle of the frame: of a test line drawn from x=0,
    only "6789ABCDE" was visible.
    - Use GEOMETRY_64_32 with a three-line layout that fits: T/R packet counts,
    RSSI and SNR, and LINK UP / "no rx 12s". Each string was measured against
    the library's font data; the worst-case widths fit.
    - Drop the last-line-received t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
    [LoRa_Transceiver.ino]
2026-09-17 Add OLED_SIMPLE: one big status word for a stick read from a distance
    The three-line screen is dense on a 0.49" panel. OLED_SIMPLE=1 swaps it for a
    16 px WAIT / LINK UP / NO LINK with one 10 px detail under it: the last RSSI
    while the link is up, or how long it has been silent. All three states and
    the worst-case details ("-140dB", "71582m ago") were rendered against the
    font data and fit the 64x32 panel.
    It defaults to 0 and can be set per stick from the command line
    (compiler.cpp.extra_flags=-DOLED_SIMPLE=1), so the committed sketch still
    builds the three-line screen. That default build matches the firmware on the
    three-line stick except for the compile timestamp and the hashes that embed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
    [LoRa_Transceiver.ino]
2026-09-17 Add phone_relay.py: text between phones over the LoRa link
    A small web relay per computer: a phone on the same Wi-Fi opens a chat page,
    and each message goes out through that computer's stick as a protocol LOG
    line and arrives on the far stick's page. With both sticks on one computer it
    runs both ends; with a stick on a laptop and one on the Jetson, each runs its
    own copy, named with --names so the two pages are easy to tell apart.
    The radio is half-duplex and two people typing will sometimes transmit at
    once, so each message carries an id, the receiving relay ACKs it (of: "LOG",
    so it cannot be mistaken for a mission ACK), and the sender retries twice
    before showing "not confirmed". A repe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
    [phone_relay.py]
2026-09-18 Group the repo into radio/, drone/, ground/, deploy/ and tests/
    Twenty-one scripts sat in the repo root, so nothing said which machine ran
    what, and the deployment files hard-coded /home/jetson/Desktop/pixhawk-test,
    which only worked because that Jetson clone happens to have that name.
    The top level now answers "where does this run?":
    radio/ the 915 MHz link end to end: protocol.py (was c2_protocol.py),
    link_test.py, phone_relay.py, listener.py (was lora_helper.py)
    and the stick firmware
    drone/ what runs on the Jetson: c2_server.py (was jetson_c2_server.py),
    missions.py, camera_publisher.py, camera.sh (was ai_camera.sh)
    and checks/ (Pixha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
2026-09-18 Add a map at the top level and a README in each folder
    Knowing where a file lives is only half of it: on a fresh machine you still
    have to work out which command to run. Each folder now states what it holds
    and the handful of commands you actually use there, and the root README opens
    with a table of the folders and what runs where.
    The per-folder notes also carry the things that bite: only one program can
    hold a stick's serial port, the C2 service holds both the Pixhawk and the
    radio, the deploy templates must be re-run after moving the repo, and the
    hotspot takes the Jetson off the internet.
    Commands were checked against the scripts rather than written from memory,
    and every markdown link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
2026-09-18 Point the new roadmap notes at the moved files
    The third-radio notes landed while the repo was being regrouped, so they
    name phone_relay.py, jetson_c2_server.py and link_test.Link at their old
    paths. Same text, current locations.
2026-09-18 Give the project a mark, a palette and a README that leads with them
    The repo read like a lab notebook: a bare title, then setup steps. It now
    opens the way the project actually works — a ground station, a radio link and
    an aircraft — and looks like one thing throughout.
    - A mark: two converging beams closing on a node in the accent colour. The V
    is the link, the node is the aircraft. Lockups for dark and light, a mark on
    its own, and a favicon that drops the arcs, which turn to mud below 24 px.
    - A palette with one rule: the accent means live. Link up, armed, in flight.
    Everywhere else is near-black, warm grey and paper, so the accent still
    means something when it appears. Writ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
2026-09-18 Redraw the mark from Sergio's logo: swept wings over a heavy V
    The first mark was hairline strokes converging on a dot — fine in a README,
    invisible across a room. This follows the logo Sergio drew: two swept wings
    over a solid V, filled rather than stroked, so it holds from a banner down to
    a favicon. The blade between the wings is dropped at his direction.
    - Monochrome. The accent reports state, and a logo is not a state, so it no
    longer appears inside the mark.
    - The tagline stays "AUTONOMOUS FLIGHT SYSTEMS", set on one line at every
    lockup size.
    - The favicon is the V alone: the wings close up into a blob below ~20 px.
    - The social card is rebuilt around the new mark and re-export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
2026-09-18 Restore the blade, add the stacked lockup, and export high-resolution PNGs
    Seen large, the version with the blade is the better mark, so it comes back,
    with the long flat wings from variant A. Same monochrome discipline.
    - A stacked lockup — mark above the wordmark — for banners, posters and title
    slides, where the horizontal one wastes the width.
    - PNG exports of everything, transparent except the social card: the mark to
    2048 px, the horizontal lockup to 3200, the stacked lockup to 2400, square
    icons at 32/180/512 in both inks, and the social card at 1x and 2x.
    - docs/BRAND.md lists the exports and says when a PNG is the right choice:
    print, posters, and anything that refuses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
2026-09-18 Run the mission tests in CI
    The only thing CI checked was that the ground station still packages into an
    .exe. The tests that matter — link-loss return-to-home, holding position when
    the camera loses the person, surviving corrupted LoRa packets — ran only when
    someone remembered to run them.
    They are stdlib-only and use a mock flight controller, so they run on every
    push in a few seconds with nothing to install. The job also compiles every
    Python file and parses every shell script, which is what catches a path
    mistake across three machines before it reaches the Jetson.
2026-09-18 Make the system diagram a live link
    The diagram now animates the round trip it was already describing: a command
    leaves GROUND over 915 MHz LoRa, the Jetson relays it to the Pixhawk over
    MAVLink, and the reply comes back the same way. A caption under the boxes names
    each leg, then settles on the resting line.
    Technique is the same one the KiCAD-MCP-Server README uses: SMIL animateMotion
    to ride a dot along a path, plus CSS keyframes on steps(1,end) for the caption
    swap. Both run inside an <img>, which is how GitHub serves README images, so no
    JavaScript is involved and nothing external is fetched.
    The static artwork is untouched. Everything that moves lives in #packets and
    #ticker, so pref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
2026-09-18 Close an 80ms hole in the caption ticker
    vt0 switched off at 14.9% but vt1 did not switch on until 16%, leaving a sliver
    of the cycle with no caption at all. Caught it on the live README: the
    GitHub-served copy starts its clock when the image finishes loading, which is
    later than a local one, and a capture landed in exactly that gap.
    The four windows now tile the cycle with handoffs at 16%, 31% and 58%, so some
    caption is visible at every instant.
2026-09-18 Trim the README to hardware, missions and the camera/LoRa architecture
    The front page was 378 lines across 16 sections, which is why the repo read as
    cluttered. It now carries the three that matter: current hardware setup,
    missions, and the camera + LoRa architecture.
    Nothing is deleted. The setup, protocol, reinstall, roadmap and brand guides
    stay in docs/, and every folder keeps its own README with the commands for that
    part, so the detail is one click away instead of on the front page.
    Two pointers into removed sections were repaired rather than left dangling: the
    camera.sh mention now points at drone/README.md, and mission 5's requirement
    names the script instead of a section heading.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
2026-09-18 Add a concept-of-operations animation to the roadmap
    A 20s cycle walks Mission 2 end to end: the operator selects it on a laptop, the
    two-step arm gate clears, the aircraft takes off, the OAK-D acquires a person,
    it follows at 3 m streaming telemetry home, the link drops, and RTL brings it
    back. It sits under the roadmap's end-goal statement, which is what it
    illustrates.
    It is labelled as the target system, and the resting caption says the missions
    are bench-tested against mocks with outdoor flight pending, so nobody reads it
    as a recording of a flight that has happened.
    Motion is CSS rather than SMIL here because this piece is almost entirely
    movement and CSS is what prefers-reduced-moti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
2026-09-18 Add the patrol and message-net animations
    patrol-*.svg — "fly to these coordinates", the mission that completes. A map
    view rather than conops' side view, because a patrol is a ground track. Follows
    drone/c2_server.py exactly: WP_BEGIN -> WP xN each ACKed -> WP_END -> validate
    (0 < alt <= MAX_ALT_M) -> ACK{uploaded} -> CONFIRM -> arm -> AUTO.TAKEOFF ->
    AUTO.MISSION -> RTL, which is the mission's own last item rather than a
    failsafe. Leg timings are proportional to leg length so the aircraft holds a
    constant speed, and the flown route is drawn with a dashoffset on the same
    schedule so the line grows exactly under it.
    mesh-*.svg — the message net. One transmission on 915 MHz and every sti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
2026-09-18 Add a landing page, and an obstacle the patrol routes around
    index.html is a GitHub Pages landing page: the lockup, the tagline and the four
    animations running full width, with a link back to the repo. It sits at the repo
    root because Pages only serves from the root or /docs, and from /docs it could
    not reach assets/brand/ — this way nothing is duplicated and no second branch is
    needed. It follows the reader's colour scheme, using the dark asset variants in
    dark mode.
    The README hero is now the conops animation, with a link to the site above it.
    The patrol gains an obstacle. The uploaded plan runs straight through it, which
    is what the operator actually plotted; the flown track goes over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
2026-09-18 Make the demo link an animated button
    A bold inverted bar, a live dot that beats, an arrow that nudges, and a Signal
    hairline sweeping across it every few seconds. It replaces a plain blue text
    link that was easy to scroll straight past.
    GitHub strips <style> and style attributes from README HTML, so the link itself
    cannot animate. Putting the motion inside an SVG and using it as the <img> of an
    <a> gets around that, which is the same reason the diagrams animate at all.
    Signal is used here within the rule rather than as decoration: the dot reports
    that there is something live at the other end of the link.
2026-09-18 Give the demo button a cyberpunk treatment
    A chamfered HUD panel with a neon edge that breathes, scanlines across the fill,
    a live dot with an expanding halo, a blinking terminal cursor, a three-chevron
    chase, a hot sweep crossing every 3.6s, and a glitch tear that displaces the top
    and bottom halves of the wordmark in opposite directions for about 40ms every
    five seconds.
    The panel stays dark in both colour schemes now rather than inverting, because
    neon needs something to burn against — the two variants differ only in panel
    depth so the button separates from either page.
    This deliberately breaks BRAND.md's "anything that reads as decoration is wrong".
    A button whose only job is to be n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
2026-09-18 Replace the README hero with a ten-second system self-test
    A console printing its own bring-up: radio, link, flight controller, camera,
    compute, C2 — then READY, and the aircraft lifts off the pad. It answers "what
    is this" in one look, which conops could not: conops is twenty seconds and
    rewards watching, and a hero has to land before a thumb moves. conops keeps its
    place on the landing page, which now opens with the self-test instead.
    The GPS line is deliberately not a tick. Phase 5 still lists the M8N as
    unfitted, so it prints "M8N · not fitted [ -- ]" in muted rather than green. A
    self-test that reported everything healthy would be the one dishonest thing in
    the repo, and the line c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
2026-09-18 Rename the button: SEE IT RUNNING -> SYSTEM OVERVIEW
    "See it running" promised a live feed. What is behind the link is animated
    diagrams of the system as designed, so the button was the last thing in the repo
    overclaiming — every animation carries a caption saying what is built and what
    is not, and then the button undid that in three words.
    It now reads SYSTEM OVERVIEW with a second line, "animated · 60 seconds", so the
    big word does the work and the small one removes the ambiguity. The button grew
    to 400x92 to carry it, and the glitch tear still only applies to the headline.
2026-09-18 Add a phase-status animation to the roadmap
    Twelve seconds walking phases 0 to 6, each lighting with what it actually is,
    then settling on the summary: four done, two in progress, one not started. It
    sits under the Status heading, above the table it reads from. conops keeps the
    top of the page — that one is the goal, this one is the position.
    The rail is deliberately not a progress bar. Progress here is not linear: 3 and
    4 are finished while 2 is still open, so a filling bar would misrepresent it.
    The rail connects, the nodes carry the state.
    State mapping follows the Signal rule rather than a traffic-light convention:
    in-progress phases pulse in Signal because they are the work that is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
2026-09-18 Open the roadmap on obstacle avoidance instead of conops
    conops showed Mission 2, which is already built and bench-tested — a strange
    thing to lead a roadmap with. This shows the furthest item on the list instead:
    the depth fan finds a wall, the distance closes, PX4 brakes at CP_DIST, and the
    aircraft routes around and rejoins.
    It is a tactical zoom rather than the patrol's route map, so it shows the
    mechanism instead of repeating the outcome the patrol already animates.
    Nothing in it is built, and the caption and surrounding text say so twice. What
    is real is both ends: camera_publisher.py already runs a spatial detection
    network on stereo depth, and PX4 1.13 already brakes on OBSTACLE_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
2026-09-18 Update roadmap title to generalize project context
    Removed specific project context from the roadmap title. — laptop-commanded follow-me drone removed
2026-09-18 Fix two things the repo audit turned up
    REINSTALL.md still called the repo flight_test and cloned from that URL. GitHub
    redirects renamed repos so it would have worked, but this is the one document
    whose whole job is rebuilding a wiped Jetson from scratch, and it should not be
    the file that is out of date. The local checkout path is left as
    ~/Desktop/pixhawk-test, which is where it actually lives on the machine.
    DEV_SETUP.md's two-machine diagram had box edges that did not line up and named
    the old feature branches — both of those branches were deleted. The diagram is rebuilt
    with every connector placed by column and asserted: the tee under the top box,
    the split, both drops, both box arr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
2026-09-18 Fix the serial-loss bugs and harden the relay's access key
    Four findings from a pass over the radio path and the web surface.
    The ground client opened its serial port without exclusive=True, while
    link_test.Link and the Jetson's LoRaLink both set it with comments explaining
    why — a stray serial monitor on the same port silently eats half the
    conversation. The one an operator actually runs in the field was the one without
    the guard. It now matches.
    Neither Link nor LoRaLink could survive the stick re-enumerating. Link printed a
    read failure on every poll, which is how a single unplug produced tens of
    thousands of identical lines during a bench session, and LoRaLink swallowed the
    exception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
    [c2_server.py, link_test.py, phone_relay.py]
2026-09-18 Document today's changes, and fix the third transport I had missed
    Checking the docs against the code turned up that I had written "it reconnects
    on its own" into ground/README.md while the ground client did no such thing.
    gcs_client.py has its own SerialTransport rather than reusing link_test.Link, so
    the earlier fix reached two of the three places that open a serial port and the
    documentation described all three. The claim came first and the behaviour did
    not exist — the worst way round.
    SerialTransport now matches the other two: closes the dead handle, reports it
    once, retries on a timer and announces the port coming back. It drops outbound
    messages while down rather than raising, beca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
2026-09-18 Write down the security posture
    The audit's main finding lived only in a conversation: nothing in the repo said
    the command link is unauthenticated. Anyone reading this code could work it out
    in a couple of minutes, but nobody flying the aircraft would be told.
    docs/SECURITY.md records it with the impact stated plainly — any transmitter in
    range that speaks this protocol is indistinguishable from the operator's ground
    station, for launching and for interrupting a flight already underway — and says
    explicitly that the two-step arm gate is not a security control. It stops a
    mistaken keypress, which is what it was built for, and both halves arrive over
    the same open channel.
    It also carri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
2026-09-18 Collapse three serial transports into one
    link_test.Link, the Jetson's LoRaLink and the ground client's SerialTransport
    were near-copies that drifted. exclusive=True reached two of them. The reconnect
    fix reached two of them, and not the same two. Each gap was the same bug found
    again in a place the previous fix had missed, which is what keeping three copies
    costs.
    radio/serial_link.py is now the only one. The differences that were real became
    options: settle waits out the firmware's boot banner for tools that open a stick
    fresh; report_raw surfaces non-protocol lines for bench tools that want to see a
    banner rather than silence; raise_on_down raises for interactive tools that can
    tell some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
    [c2_server.py, link_test.py, serial_link.py]
2026-09-18 Authenticate the command link
    radio/auth.py signs each message with a truncated HMAC-SHA256 over its canonical
    form plus a per-message nonce. A receiver holding the key drops anything
    unsigned, tampered with, replayed or signed with a different key, before it
    reaches the dispatcher that can arm an aircraft.
    It is off until a key file exists, and with no key the link behaves exactly as
    it did before — byte for byte. That is the point: this could be deployed to the
    Jetson and the laptop on different days without either stopping working, and
    becomes mandatory the moment both hold the same key. What would have been a flag
    day is now a thing you switch on at the bench with both ends in front o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
2026-09-19 Correct two false claims in the security doc, and record the camera stream
    SECURITY.md said "the server defaults to a mock flight controller with props
    off; --real and --props-on are both opt-in". Both halves of that were wrong.
    Props default ON. C2Server takes props_off=False, --props-on is a no-op whose
    own help text says "(default) ... kept for compatibility", and --props-off is
    the flag that does something. The interlock stops motor tests running with props
    fitted and blocks flight once props are declared off; it is not a default-safe
    gate. That is deliberate — tests/test_missions.py asserts "props default to ON
    (flight ready out of the box)" — so the code is not the thing to change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
2026-09-19 Put the flight failsafes in one place
    run_flight, run_mission1 and run_mission2 each had their own copy of how a
    flight is watched: answer PINGs, honour ABORT, come home when the link goes
    quiet, push a status heartbeat, notice the disarm that ends it, give up at the
    time cap. Five concerns, three implementations, 408 lines.
    They had already started to diverge. Only run_flight logged an ABORT; the other
    two sent it to the client and left nothing in the journal. Only run_flight
    logged the time cap. mission2 tracked its ending in a tri-state while the others
    used a bool, so the same event produced different status.
    This repo has already paid for this shape once. The serial transport was thre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
    [c2_server.py]
2026-09-23 Make the dev-setup docs tool-neutral
    Describe the two-machine workflow in terms of cloud vs. local sessions
    rather than a specific assistant product. The technical guidance is
    unchanged: a cloud environment has no USB access, so anything touching
    the radio, Pixhawk or camera runs from a local terminal on that machine.
2026-09-28 Add the wildlife cameras: CSI day/night feed and OAK-D detection
    Two cameras that cover for each other. Camera 1 is the OAK-D-S2, which
    does daytime detection with stereo depth and runs inference on its own
    VPU so the Jetson SoC stays inside the 7 W budget. Camera 2 is the
    IMX219-160 IR-CUT on CAM0, wide-angle and IR-sensitive.
    Kept separate from camera_publisher.py, the flight person-tracker. That
    one needs depthai 2.32; this needs 3.10, and the APIs are incompatible,
    so neither runs in the other's interpreter. Nothing here touches it.
    Day/night is switched on a clock, not on the image. Metering was tried
    and does not work: in a pitch-dark room the meter reported a mean luma
    of 101.5 agai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
2026-09-28 Guard the 7 W budget, and add the OAK night-vision path
    The rig came back at 15 W after a reboot on 2026-09-28 and nothing caught
    it. The live power mode was never checked, and even checking it would not
    have helped: /etc/nvpmodel.conf still carried DEFAULT=0, so the setting
    was always going to lose on the next boot. system_check.sh now verifies
    the live mode, the boot default and the saved state separately, and
    prints the exact command to fix each.
    Also adds the OAK's actual low-light path. The mono OV9282 pair is far
    more sensitive than the colour camera: in the same dark room the CSI
    IMX219 produced a blank field (std 0.5) while the monos produced a usable
    30 fps image (std 15.6), and at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
2026-09-28 Fix three defects the pre-push review turned up
    pgrep -f matches any process whose command line merely contains the
    search text - the shell running the check, a terminal where someone
    typed the name, the pgrep pipeline itself. check_camera.sh believed a
    feed was running when none was and silently skipped its capture test,
    the single most important thing that file does. Verified directly: a
    bare pgrep matched the calling shell, script_pid rejects it and still
    finds a real feed. Four call sites shared the defect, so the lookup now
    lives in lib_pid.sh and confirms each candidate is really an interpreter
    running the script.
    The capture threshold was calibrated on a lit colour scene and failed
    e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
2026-09-28 Switch the OAK between colour and mono automatically
    Camera 1 now picks its sensor from the light: the IMX378 in daylight,
    the OV9282 mono below it. The mono gathers roughly 6x more light, so the
    useful range of the payload extends well past the point where the colour
    camera is finished.
    The decision reads what auto-exposure chose rather than how bright the
    picture looks. Brightness is useless for this - AE drives every scene
    toward mid-grey, which is why the CSI camera's meter reported 101/255 in
    a blacked-out room against a night threshold of 40. Exposure and ISO are
    a direct measure of how much light arrived. Measured here in the dark,
    CAM_A sat at 30008 us and ISO 1599, both maxed, whil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
2026-10-02 Document the X500 V2 and Pixhawk 6X upgrade
    The aircraft was replaced: a DJI F550-style hexacopter on a Pixhawk 2.4.8
    with no GPS fitted is now a Holybro X500 V2 quadcopter on a Pixhawk 6X with
    a Holybro M10 that is fitted and getting a fix. The mission, the Jetson Orin
    Nano, the OAK-D and the LoRa C2 link are unchanged.
    Three PX4 parameters existed only because of the old board and should not be
    carried over without re-testing: SYS_AUTOSTART=6001 is a hexacopter airframe
    and is wrong for four motors, COM_ARM_WO_GPS=1 only made sense with no GPS
    fitted, and COM_CPU_MAX=-1 worked around an FMUv2 quirk the 6X does not have.
    The reinstall table no longer claims these survive a rebuild, because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
2026-10-02 Show the new aircraft in the hero and the system diagram
    Both generated assets described the old aircraft, so the published site was
    advertising a Pixhawk 2.4.8 running PX4 v1.13.3 on a hexarotor. The hero now
    reads Pixhawk 6X / FMUv6X and the system diagram's AIRFRAME box agrees. The
    firmware version is left out rather than guessed: FMUv6X is known, the PX4
    version on the new board is not.
    The hero's GPS line was the one deliberate non-OK, because a hero that ticked
    everything green would be the one dishonest thing in the project. The M10 is
    fitted and getting a fix, so that line is now a genuine OK and a new FLIGHT
    line takes the role: the aircraft still has not flown outdoors. Eight rows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
2026-10-02 Rebuild the landing page as a product page
    The page read as a README: everything centred at 1040 px, a 15 px body, and
    six sections built from the identical label, heading, caption, figure block.
    For someone walking past a screen at a symposium that buries the one thing
    worth knowing, which is that this flies with no network of any kind.
    The hero now leads with that, composed as a split with the headline left and
    the copy and actions right, over the self-test as a full-bleed figure. A band
    of four numbers follows, each carrying where it came from: the 915 MHz link is
    validated on hardware, while endurance and payload are Holybro's figures for
    the stock airframe and say so, because this buil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
2026-10-02 Render the hero from Holybro's own CAD
    The first hero was modelled from the published dimensions because Blender
    reads no STEP and the asset libraries want an API key. The STEP file turned up
    in Downloads, so the aircraft on the page is now Holybro's own geometry rather
    than my approximation of it: 244 parts and 1.4 million polygons, including the
    plates, the arm clamps, the carbon tubes, the 2216 motors, the GPS mast, the
    PM06 power module, the XT60 lead and several hundred real fasteners. Only the
    propellers are still built here, since the frame CAD does not carry them.
    cascadio converts the STEP to glTF, which Blender does read. The conversion is
    worth recording: the motors land at exact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
2026-10-02 Render the aircraft from manufacturer CAD
    The hero was a model built by eye from the published dimensions. It is now a
    render of the real thing: Holybro's frame STEP, NVIDIA's Orin Nano STEP, the
    Pixhawk 6X, and a downloaded 10x4.7 propeller scaled to a true 254 mm. Two and
    a quarter million polygons, and every part of it is somebody's actual CAD
    rather than my approximation of it.
    Blender reads no STEP, so cascadio converts each file to glTF first. Two things
    that cost time and are worth leaving written down: the glTF importer sets
    rotation_mode to QUATERNION, so assigning rotation_euler does nothing and fails
    silently; and the CAD part numbers survive on the mesh data, not the objects,
    wh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
2026-10-04 Own the propeller, and name the camera correctly
    The propeller in these renders was modelled in Onshape for this project,
    replacing a downloaded STL whose author and licence were never recorded. That
    was the one open provenance item in BRAND.md and it is now closed. The Pixhawk
    CAD's exact source is still unrecorded, so the note points there instead of
    claiming nothing is outstanding.
    The camera is an OAK-D Pro, not a plain OAK-D. It has an IR dot projector and
    flood IR illumination the plain model does not, and the page claimed the wrong
    part.
2026-10-04 Let the aircraft arm and leave the ground as you scroll
    The two-step arm gate is the part of the protocol that is hardest to convey in
    a diagram: nothing spins until a second confirm comes back over the same link.
    So the page now shows it. FLY_REQ, ACK, CONFIRM, STATUS are the real strings
    from radio/protocol.py, not invented UI.
    No JavaScript, as ever. CSS scroll-driven animation ties the keyframes to the
    section's pass through the viewport, gated behind both prefers-reduced-motion
    and @supports. Without the @supports a browser that ignores animation-timeline
    would run the keyframes on the document timeline and fly the aircraft away once
    on load; with it, those browsers get a still photogr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
2026-10-04 Split the site into a product page and a how-it-works page
    One scroll had to carry the hero, the stats, the system diagram, the self-test,
    the takeoff, three mission diagrams and the phase chart. It was too much for one
    page, so it is two: index.html shows the aircraft, how-it-works.html explains it.
    The product page gains a hardware gallery. Seven Cycles renders from the
    manufacturers' own CAD, each captioned in real HTML rather than text burned into
    the image, so a screen reader reads them and they rescale on a phone. The motor
    tile says plainly that Holybro's CAD and the kit listing disagree on the KV
    rating, because they do and it is not resolved.
    how-it-works.html finally uses avoid-l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
2026-10-05 Make the hero a scroll-scrubbed cinematic, and spend the no-JS convention
    The product page opened on a still photograph and then asked you to scroll past
    an arming animation to learn what the aircraft is. Now the first thing you see
    is the aircraft coming apart: 120 Cycles frames, advanced against scroll
    position, through the explode, a full 360 with the four computers labelled, and
    a static hold at the end so there is time to read them.
    The labels are real HTML text positioned from data Blender exported, not pixels
    burned into the render. A screen reader reads them, they stay crisp at any size,
    and they restyle for dark mode on their own.
    This ends the no-JavaScript convention, knowingly.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
2026-10-05 Light the Jetson close-up, and put the radio in it
    The Jetson tile was half the brightness of every other render in the gallery:
    mean luminance 22 against 33 to 59 for its neighbours, and a median of 9, which
    is to say half the frame was effectively black. The cause was not exposure. The
    Jetson sits under the payload shelf and the camera looks up at it from 41
    degrees below, while all four lamps in the scene sit above z = +0.05. Nothing
    was lighting it at all.
    So a shot can now ask for its own fill. render_stills.py builds a soft area
    light from the shot table, renders, and removes it again, which keeps it out of
    every other shot and out of the .blend. This one gets 12 W from below-starboar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
2026-10-05 Reshoot the two tiles whose pictures did not match their captions
    An audit of the gallery turned up two renders making claims the image did not
    support. Both were framing, not geometry or materials.
    cu-arm said "carbon arm and clamp" and showed the whole aircraft. The shot aimed
    at the body centre with a 170 mm subject, so the clamp it names was a small part
    of a wide three-quarter view. It is now the inboard clamp itself, 40 mm across,
    where the carbon tube meets the body plate.
    The caption also said the Holybro name "shows in close-up". It did not, in that
    render or any other. The embossing is real and in Holybro's CAD, but it is on
    the motor mounts, not the arm clamps, and nothing we sh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
2026-10-05 Recut the hero as expansion and reassembly, and stop throwing away resolution
    The 360 is gone. A full orbit on top of fifteen groups moving on their own axes
    was too much happening at once to read. The piece is now whole, apart, named,
    back together, whole: 220 frames with the camera drifting through a 20 degree
    arc instead of orbiting, which gives parallax without asking the eye to track a
    rotation as well. It ends on the assembled aircraft, unlabelled, nearer than it
    began — the labels live only on the held-open beat, frames 90 to 135.
    The hero was also soft, and for a bad reason. The frames were encoded at 1100 px
    and a 1440 px screen stretched them to 1425; the renders are 1920x1080,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
2026-10-05 Pin the hero on a phone, and spell out the acronyms
    Two things, both from reading the site on a 393x852 iPhone.
    ## The hero finished after it had left the screen
    The aircraft came apart as you scrolled and was gone before it went back
    together. The cause was geometry. An earlier change took the hero out of its
    sticky full-screen stage on narrow screens, because a 1.46:1 image in a 100vh
    pane is 269 px inside 852 and left 583 px of black on every frame. But an image
    in the flow only gets as much scroll as its own journey across the viewport, and
    that was 419 px of full visibility against a 120-frame sequence: frames 0 to 72
    while you could see it, 73 to 119 while it slid off the top.
    It no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
2026-10-05 Replace the plates grid with a single-box viewer that opens full size
    Eight thumbnails in a column flow was the wrong way to look at the detailed
    renders. The section is now one box showing one view at a time -- plan, side
    elevation, front elevation, three-quarter, in that order -- with arrows, dots,
    and the view named underneath. Clicking it opens that render at full size.
    The four views were re-rendered for this. The sources were below 1080p: the
    elevations were 1600x900, so "open it at full size" would have meant opening
    something smaller than the screen it opened on. They are now 1920x1080, the plan
    view 1920x1920, and each ships twice -- 1400 px inline and the full render for
    the opene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
2026-10-05 Play the hero once instead of scrubbing it, so the numbers clear the fold
    The complaint was that the first screen was the aircraft and then a long black
    nothing, with the numbers band nearly three screens down. The cause was not the
    animation, it was what a scroll-driven animation costs: it has to reserve its
    length as document space, and that space sat between the aircraft and the
    numbers. At 240vh of stage the band started at 2596 px on a 900 px screen.
    Trimming the stage does not fix it, because the numbers come after the whole
    stage rather than after the frame. So the sequence is no longer tied to scroll.
    It plays itself once, on a clock, when the aircraft comes into view, and holds
    on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
2026-10-05 Add a social card, clear the dead CSS, and stop the hero depending on load
    Three loose ends from the audit.
    **A shared link rendered as a bare URL.** Both pages now carry Open Graph and a
    canonical, with a 1200x630 card cut from the social render. It ships as JPEG
    rather than the WebP that was sitting beside it unreferenced: every crawler
    handles JPEG, and a card nobody can decode is the same as no card. Only
    twitter:card is doubled up, because Twitter reads the og: tags for the rest.
    **Dead CSS.** Removing the plates grid and its footnote left seven rules with
    nothing to style, in both copies of the stylesheet. Gone, along with .pair,
    .split and .split .fig, which were orphan responsive o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
2026-10-05 Open the README on the aircraft, not the self-test
    Someone landing on the repository met a terminal readout before they met the
    machine. The product page leads with the aircraft; this makes the README agree.
    A plan view of the X500 V2, drawn from the CAD rather than sketched: motors at
    +/-178 mm on both axes, 144 mm plates, 254 mm propellers, the GPS mast at +99
    mm. The five things bolted to it are named, each with a leader to where it
    actually sits.
    Motion obeys the rule in BRAND.md. The airframe draws because that is the
    airframe, and each label lands because that part is on the aircraft. Nothing
    spins to fill the space. The accent appears once, on the radio, because the
    radio is the liv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
2026-10-09 Open how-it-works on the mission, and make the README button a button
    The banner is a new generated SVG, tools/gen_mission.py, in the same
    language as the other diagrams: fence a search area, plan a path that
    covers it, tilt from map to altitude, sweep it, find one person who is
    not moving and raise an emergency over LoRa, find one who is moving and
    follow at 3 m, come home. 31 KB a theme, against 15 MB for the index
    hero, and it rests as a readable still under prefers-reduced-motion.
    Half of it is not built and it says so beat by beat rather than in one
    disclaimer at the end. camera_publisher.py runs a person detector with
    depth and no pose, so still-versus-moving is a concept here and not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
2026-10-09 Replace COCO with MegaDetector, and give classes a threshold each
    The detector could not see its own subjects. YOLOv6-nano is COCO-trained
    and COCO has no deer, hog, coyote, bobcat, javelina or armadillo class,
    but the failure was not absence - it was confident error. On the eight
    species in ~/Pictures/testset/ it called a feral hog a bird six times at
    up to 86%, a javelina a sheep at 70%, and missed a white-tailed deer
    entirely. On the 89 bench frames in ~/Pictures/wildlife it produced 26
    detections at conf 0.5, of which 25 were "traffic light" at 61% mean
    confidence, fired on warehouse ceiling lights. No threshold fixes that.
    MegaDetector V6 compact reports animal/person/vehicle, is train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
2026-10-09 Say the mission works, put a tree in the lane, and log a deer
    The banner is the product now, not a progress report. Every "not built",
    "Phase 6, not started" and "bench-tested against mocks" chip is gone and
    the beats read in the present tense; the resting line is the pitch rather
    than an inventory of what is and is not finished.
    Worth knowing, because the two are one click apart: docs/ROADMAP.md still
    says Phase 6 obstacle avoidance is not started and outdoor flight is
    pending, and camera_publisher.py is a person detector with depth and no
    pose. Nothing here asserts a flight has happened -- the captions describe
    the system operating, not its build state -- but if the roadmap stays as
    it is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
2026-10-09 Add an operator GUI, encoded on the camera rather than the Jetson
    There was no way to see the aircraft without a monitor plugged into it. The
    nearest thing was camera_publisher.py's stream, which served the 300x300
    network input upscaled to 600x600 with boxes burned in, software-JPEG encoded,
    polled at 2 Hz, with no key, no token and no check of any kind on 0.0.0.0 -
    SECURITY.md item 4.
    The Orin Nano has no hardware video encoder. nvvideo4linux2 exposes exactly
    one feature, nvv4l2decoder; there is no NVENC node and nvv4l2h264enc does not
    exist. ffmpeg lists h264_nvenc and friends but every one fails at runtime, it
    being a generic arm64 build. So H.264 here means software x264enc burning CPU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
2026-10-09 Commit the aircraft model, and say which document is the status
    blender/x500_cad.blend is the master every render and every animation
    frame in this repo comes from. Until now it existed in exactly one
    unversioned folder on one machine, with no backup, which both handoff
    documents have had as the top open item for a while. It is here through
    Git LFS -- 49 MB is under GitHub's hard limit but not something to put in
    the history directly, and a clone without LFS gets a pointer and a line in
    blender/README.md telling it what to run.
    This sets aside a rule the project wrote down for itself. docs/BRAND.md
    says vendor CAD is not committed here, because the Holybro, NVIDIA,
    Pixhawk and Luxonis geome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
    [x500_cad.blend]
2026-10-09 Give the detector a memory: object tracking, dwell, and throttled evidence
    The detector had no identity for anything it saw. Every frame's detections were
    consumed and discarded, so nothing could answer how long something had been
    there, whether it was the same animal, or how many distinct creatures walked
    past. Three things needed that and could not be built without it: dwell time in
    the GUI, an honest count of what a sortie saw, and the SAR prone gate, which has
    to know a subject has been motionless and horizontal for several continuous
    seconds.
    dai.node.ObjectTracker now runs on the camera and the loop reads tracklets
    instead of raw detections - same boxes, plus a stable id, an age and a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
2026-10-09 Correct the USB speed note: 480 Mbps when idle is normal
    Booting the Myriad X resets and re-enumerates it, so the OAK appears under two
    USB identities - 03e7:2485 in ROM bootloader mode on the 2.0 bus at 480 Mbps,
    and 03e7:f63b once the firmware is loaded, on the 3.0 bus at 5000 Mbps. Any
    lsusb or oak_camera.sh status run between pipelines therefore reports USB 2.0
    speeds from a device that will negotiate SuperSpeed the moment it is used.
    This was previously recorded as a defect to fix by moving the camera to a USB
    3.0 hub, and then read as a flapping link worth chasing a cable over. Both were
    wrong: every 480 Mbps reading taken today was the device idle, and every reading
    taken with a pipe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
2026-10-21 Re-check the props and GPS gates when CONFIRM arrives
    The interlocks were read when a flight was *prepared* and never again, so a
    CONFIRM arriving up to PENDING_CONFIRM_S (60 s) later launched on a stale
    verdict. Props toggle immediately -- menu id 6 has no confirm step of its own --
    so RUN 8 / RUN 6 / CONFIRM armed and took off with props declared OFF, and a
    GPS fix dropped inside the window went equally unnoticed. The link is
    unauthenticated while the handheld remote is in use, so anything in radio range
    could inject that toggle.
    confirm() now re-runs the gates before dispatch and refuses with PX4's own
    reason. It gates on `_pending` being set rather than on a list of flight names,
    so a f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
2026-10-21 Spin motors with MAV_CMD_ACTUATOR_TEST, which PX4 actually implements
    MAV_CMD_DO_MOTOR_TEST is an ArduPilot command. It appears nowhere in PX4, so
    the 6X answered every motor test MAV_RESULT_UNSUPPORTED and no output was ever
    driven. MockFC.run_mission() returns True unconditionally, so the whole bench
    suite passed over a command the real firmware has never had -- which is why the
    motors had never actually turned through this path.
    PX4's equivalent, and what QGroundControl's slider uses, is
    MAV_CMD_ACTUATOR_TEST: param1 a normalised 0..1 output, param2 a mandatory
    timeout in seconds, param5 the output function. Commander::handleCommand-
    ActuatorTest() reads param5 in the MAVLink numbering (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
2026-10-21 Field mode: host a network, serve the camera, open it on a phone by itself
    The operator GUI only worked with somebody at the Jetson: bring up the hotspot,
    type a password, start the camera, read a token off the terminal, type a URL
    into a phone. None of that is possible on an airframe in a field, which is the
    only place the thing is meant to be used.
    deploy/field_mode.sh is now the single entry point, and installs two units.
    venator-net-fallback waits up to 45 s for NetworkManager to join a network it
    already knows; if none appears it brings up the VenatorDrone access point.
    venator-gui runs the camera server either way. Everything goes through systemd
    so running it by hand and booting are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
2026-10-21 Fly motor tests and a 3 ft hover from the handheld LoRa remote
    The remote (Heltec WiFi LoRa 32 V3 + rotary encoder) gets its own sketch,
    radio/firmware/Venator_Remote, speaking the C2 protocol directly to
    drone/c2_server.py: test each motor, test all motors, hover 3 ft, drone
    status. Its previous firmware only ever sent HELLO and ignored the reply.
    On the server:
    - Hover 3 ft (menu id 8): takeoff to 0.91 m, hold 10 s, land in place.
    Gated on props ON + a GPS fix, launched only by CONFIRM. Every failsafe
    LANDs: on this vehicle RTL first climbs to RTL_DESCEND_ALT (10 m).
    - MonitoredFlight takes the failsafe mode; Mission 1/2 keep RTL.
    - A prepared flight lapses after 60 s, and ABORT befor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
2026-10-22 Talk to the drone from the Pico + RYLR998 gateway
    The RYLR998 frames every packet with a 5-byte header (dest LE16, src LE16,
    length) and drops packets without one. LoRa_Transceiver now strips that header
    on receive and adds one on send while its last peer used it, so plain-LoRa
    peers like the Heltec remote are unchanged.
    radio/firmware/Pico_Gateway/main.py reworks the Pico gateway to speak the C2
    protocol with the Heltec remote's menu and safety rules, and sets the RYLR998
    to the bridge's radio settings (NETWORKID 18 = sync word 0x12, preamble 8).
    Verified over the air against the mock FC: HELLO, PING, RUN 2 -> DONE, and the
    hover refused with props OFF.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
2026-10-22 Let the Pico gateway's menu work before the drone answers
    It started in a linking state that ignored the knob and buttons until a
    HELLO_ACK arrived, so with the drone off the whole controller looked dead.
    It now starts in the menu and keeps sending HELLO in the background.
2026-10-22 Add a setup wizard for commissioning a hand-built remote
    A second remote is hand-wired, so the first question is never "does the
    protocol work" but "is this encoder soldered the way the last one was". Holding
    BACK through boot now runs a five-step wizard: knob click, three detents
    clockwise, three anticlockwise, a BACK press, then HELLO until the drone answers
    and the RSSI is on screen.
    Steps 2 and 3 do the real work. On a hand-soldered KY-040 the A and B channels
    end up swapped about half the time, which inverts the knob while leaving every
    line of code correct. If clockwise counts down and anticlockwise counts up, the
    wizard writes encInvert to NVS and takeDetents() negates from then on -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
2026-10-22 Give the camera its own key, so it stops muting the handheld remote
    venator-gui.service's ExecStartPre ran field_mode.sh _require_key, which called
    radio/auth.py --init and created ~/.venator/key. serial_link.py defaults
    auth_key=auth.load_key() and drops every message that fails verify(), and the
    handheld remote does not sign -- so bringing the camera up on boot silently
    killed RUN 1/2/7 from the remote, every boot. That is where the key found on
    this Jetson on 2026-10-21 came from. The two things the aircraft is meant to do
    at once were mutually exclusive.
    No new crypto was needed. radio/auth.py's key_path() already honours
    VENATOR_KEY_FILE, and every consumer resolves through it: auth.py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
2026-10-22 Make the docs describe the aircraft and the services that actually exist
    A sweep for places where the repo contradicted the hardware, the filenames or
    today's behaviour. This project treats comments as a decision record, so a
    comment asserting the opposite of the code is worse than no comment.
    EQUIPMENT. missions.py called itself "Bench-test missions for the Pixhawk 2.4.8
    (PX4 v1.13.3) hexarotor" -- the previous aircraft, and a dangerous label on the
    file that drives the motors, because it invites --motors 6 and two commands to
    outputs an X500 V2 quad does not have. Same in its menu banner and in
    check_pixhawk.py's header. c2_server.py's usage block and link_test.py still
    named jetson_c2_se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
2026-10-22 Fix the phases SVG build that my roadmap edit broke
    tests.yml runs every tools/gen_*.py and then `git diff --exit-code -- assets/brand`,
    and gen_phases.py reads its state straight out of the roadmap's Status table.
    The previous commit rewrote that table without re-running the generator, so the
    build went red two ways.
    First, phase 5's state was changed to a warning emoji. read_states() matches
    only (✅|🔵|⬜), so the row became invisible to it and the script exited with
    "no row in the Status table for phase(s) 5" -- a stray marker in the table reads,
    from inside the generator, as a missing phase. Phase 5 is 🔵 again and the
    "blocked on fix_type 0" detail stays in the row text, where i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
2026-10-22 Write down that only one remote may be powered at a time
    Two kinds of peer now talk to LoRa_Transceiver and they want different things on
    the air: the Heltec handheld and the laptop GCS want the raw JSON line, the Pico
    + RYLR998 wants it behind a 5-byte REYAX header. The sketch adapts per packet,
    keying off the fact that a protocol line always starts '{'. That is right with
    one remote powered and needs no configuration.
    But peerRylr is a single global set by the LAST packet heard, so with both
    remotes live it is last-writer-wins and every reply goes out in whichever
    framing the other remote most recently caused. The Pico transmits, the reply is
    framed, and the handheld finds five binary byt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
2026-10-27 Only report a flight phase from missions that have phases
    After the failsafes moved into MonitoredFlight, every flight started sending a
    phase field, defaulting to "takeoff". The waypoint flight never updates it, and
    the ground client renders phase whenever it is present, so a waypoint flight
    would read "takeoff" all the way round the route.
    Phase is now opt-in: a mission passes phase="takeoff" when it has phases, and
    one that does not sends no phase field at all, as before the refactor. The
    three missions that drive phases declare it -- mission 1, mission 2, and the
    3 ft hover from the handheld remote. The hover mission matters most here: its
    loop starts from flight.phase == "takeoff", so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
2026-10-27 Show the GPS fault in the self-test hero
    The hero printed "GPS M10 · 3D fix [ OK ]". It was written on Oct 2, and on
    Oct 21 the roadmap recorded that PX4 reports fix_type 0 with 0 satellites -- an
    M10 cable/port fault -- which is now the blocker for outdoor flight. The README's
    first image was claiming the one thing that is currently broken.
    It now reads "M10 · no fix — cable fault [ -- ]", greyed like the FLIGHT line,
    and the alt text says the same. The docstring asks that these two lines follow
    docs/ROADMAP.md when the hardware changes, since the roadmap is the record of
    what is true.
2026-10-29 Add a camera icon that hands out an address which cannot fail
    Two problems on the bench tonight, with the same root: the demo was depending on
    the one part of the camera path that has a moving piece in it.
    venatordrone.com does not load from a phone on the access point. The portal
    needs DNS *and* an nft rule redirecting port 80 to 8080, and the dispatcher hook
    logged "FAILED to load /etc/venator/portal.nft" when the hotspot came up at
    19:35:47. DNS resolves, nothing listens on 80, and the phone gets a dead
    connection with no indication why. Root cause of the nft failure is still open --
    the hook discards nft's stderr, so the log says only that it failed.
    But the server listens on 8080 rega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
2026-10-29 Add a one-click live view on the Jetson itself
    The desktop had no way to watch the camera without either a terminal full of
    addresses or an X_LINK_DEVICE_ALREADY_IN_USE crash. camera.sh preview and
    oak_camera.sh detect both reach for the OAK, which venator-gui already owns, so
    the obvious-looking icons are exactly the ones that fail.
    6 · Live view opens the stream the service is already serving -- same page the
    phone gets, detection boxes drawn client-side -- in a window, with no terminal
    and no second claim on the device. Right-click gives the raw MJPEG without the
    page, or the newest saved frame.
    symposium_camera.sh gains --view and --view-raw, which print nothing and exec
    the browser.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
2026-10-29 Run the mission dashboard without .NET, as one Symposium icon
    The VENATOR dashboard we want for demo day lives in
    XSilverEyeX/drone-mission-planner-css on branch venator-gui-iteration-3 --
    props-off Arm, a brief motor test, Disarm, a flight-mode dropdown, attitude and
    heading and downward range, baseline capture, telemetry export, PX4 health
    messages, with 35 hardware-free bridge tests behind it. Its stack is browser ->
    C# ASP.NET -> Python bridge -> MAVLink, and this Jetson is aarch64 with no .NET
    SDK. Installing the .NET 10 ARM64 SDK and doing a first build hours before a
    presentation is not a trade worth making.
    It also turns out not to be necessary. Of the ten routes in Program.cs exact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
2026-10-29 Make a second click on the dashboard icon adopt, not crash
    Clicking 7 · Mission dashboard while it was already running ended in
    "OSError: [Errno 98] Address already in use" from the bridge. Two things made
    that worse than a duplicate-launch error should be.
    drone_bridge.py prints "[bridge] Listening on 127.0.0.1:5555" BEFORE it binds,
    so the traceback reads as though it started and then died, rather than never
    having started at all.
    And by the time it failed, this script had already stopped venator-c2 on behalf
    of a run that was never going to work -- so a stray double-click killed the
    handheld LoRa remote and left nothing in its place.
    The port check now runs before anything is stopped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
2026-10-29 Make the access point the address, not one option among several
    The dashboard script printed every interface it could find, in whatever order
    the kernel listed them, so a venue Wi-Fi address came out looking exactly as
    authoritative as the drone's own. That is backwards. This aircraft exists to
    work with no internet, no cellular and no ground-control software; it hosts
    VenatorDrone on 10.42.0.1 and the phone joins that. A URL that only resolves on
    someone else's router is a bench convenience, not the product, and should never
    be the thing demonstrated.
    Now 10.42.0.1 is printed first and alone. When the AP is down it still shows
    that address, says so, and gives the command to bring it up --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
2026-10-29 Rename the portal domain to venator.com
    Nineteen occurrences across eight files, changed together because the name has
    to agree in four independent places or the portal half-works in a way that is
    hard to read: the dnsmasq answer, the RFC 8908 DHCP option 114 URL, the
    PORTAL_HOST that gui_server.py matches Host headers against, and the address
    the portal page itself tells the operator to type.
    That last pair is the one that bites. gui_server.py builds LOCAL_HOSTS from
    PORTAL_HOST and redirects any Host it does not recognise to the portal, so a
    stale name there would have sent the correctly-resolved domain into a redirect
    loop rather than serving the camera.
    tests/test_captive.py asserts on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
2026-10-29 Use dnat, not redirect: L4T has no nft_redir
    The captive portal has never worked on this Jetson. The dispatcher fired
    correctly every time the hotspot came up and nft rejected the rule every time:
    /etc/venator/portal.nft:47:60-67: Error: Could not process rule:
    No such file or directory
    iifname "wlP1p1s0" ip daddr 10.42.0.1 tcp dport 80 redirect to :8080
    ^^^^^^^^
    "No such file or directory" pointing at a statement is nftables reporting a
    missing kernel module, not a missing file. `redirect` needs nft_redir, and
    modinfo confirms the L4T kernel does not build it -- so that rule could n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
2026-10-29 Add a QR sheet for the phone, and make the port-80 rule testable
    The captive portal has never worked on this hardware, so the phone path has
    never had a fallback. These three changes give it one and make the portal's
    failure visible instead of silent.
    A QR SHEET THAT TOUCHES NO DNS AND NO FIREWALL RULE
    deploy/symposium_qr.sh writes a printable page and one PNG per code: join the
    Wi-Fi, open the camera, open the dashboard. The URLs name the address the
    server actually listens on, so they work whether or not the portal does --
    which matters when the alternative has never once succeeded here.
    Two decisions worth recording. The token is read from field_mode.sh at
    generation time rather than h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
2026-10-29 Check the dashboard, which nothing was checking
    The QR sheet advertises :5037, and unlike the camera that port is not backed by
    a systemd unit. symposium_dashboard.sh starts it by hand because it has to stop
    venator-c2 first -- one owner per serial port -- and give the port back from an
    EXIT trap. So any reboot leaves the dashboard QR pointing at a closed port
    while venator-gui, venator-c2 and venator-net-fallback all come up clean and
    the pre-demo check prints ALL CLEAR.
    That is the same shape as the portal bug: not a thing that broke, a thing that
    nothing looked at. symposium_check.sh now curls :5037.
    It WARNS rather than FAILS. The dashboard is optional to the camera demo, and
    turning t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
2026-10-29 Load the detector from disk, not from the internet
    The camera server could not start without internet, which means it could not
    start on the access point -- the one network it exists to serve.
    dai.getModelFromZoo() contacts the Luxonis API to resolve a model name to a
    version BEFORE it will consider the cache, and it does that on the main thread
    holding the GIL. On a captive campus network the request connected and then
    stopped: observed stalled at exactly 5767 bytes received across three samples
    two seconds apart, eight minutes after start, with no progress. On the access
    point there is no route at all.
    The symptom was not "the camera is slow". It was every page on every device
    hanging, a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
2026-10-29 Stop the portal check blaming the firewall for a wedged server
    curl reports 000 for a refusal and for a timeout alike, and the two have
    opposite causes: no redirect rule, versus a redirect pointing at a server that
    is not accepting. The check asserted the first unconditionally, so it printed
    "the dnat rule did not load" directly underneath its own line reporting the nft
    table as loaded -- and sent us hunting the firewall while gui_server sat there
    with a full accept queue.
    It now probes :8080 before attributing blame and names whichever suspect the
    evidence actually supports, including how to tell wedged from dead (Recv-Q
    sitting at the backlog in ss).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
2026-10-29 Fit the whole check on screen, and let it skip the FC probe
    The check grew a captive-portal section, a dashboard section and a QR section
    and now prints 45 lines. A default gnome-terminal is 24, so Boot services and
    Props scrolled off the top -- the operator reads the second half and can miss a
    FAIL on a service while looking at a green camera. --geometry=100x52 fits it.
    The launcher Comment still described only the original sections, so the icon
    understated what it covers. It now names the portal, dashboard and QR checks.
    Three actions added: the phone path alone (SKIP_FC=1), open the QR sheet, and a
    one-line dashboard probe -- the things worth re-running outside between the
    aircraft and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
2026-10-30 Search for the person in the red vest, and ignore everyone else
    The search-and-rescue simulation. A person is detected first, then the
    colour of their chest is voted on across about a second, so a flickering
    wrong answer can't get through. The lock stays on one person, and a clear
    reading of another colour drops it within 0.3 s.
    - vest.py: the search, with no camera dependency, so CI runs the same logic
    the aircraft does. Votes and the lock survive a detection dropout, which
    otherwise hands someone a new id and costs them both.
    - gui_server.py --search: the target, role and vest on every box, a FOUND
    alert with one evidence photo, and a report over loopback UDP. Off by
    default, beca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
2026-11-03 Add a poster view to the confidence chart
    A snapshot of the live chart was a dark strip 150 px tall with tiny text, which
    reads badly on a white poster. The poster button redraws the chart large and
    white, and a snapshot taken with it on saves at 3000 x 1500, which is 10 x 5
    inches at 300 pixels per inch.
    - The colours are darker than the screen's, so they read on white: at least
    3:1 for lines and 4.5:1 for text. Each vest also has its own line style.
    - The image says what it measured, the detector and the time, so it can't be
    mistaken for a theoretical graph once it leaves the page.
    - Every snapshot gets a save PNG button, so nobody has to right-click on a phone.
    - It only whitens the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
2026-11-07 Add website search controls, calibration and a trial recorder to the vest search
2026-11-07 Add a Jetson update runbook and a read-only ARK Flow check
    docs/JETSON_UPDATE.md takes an installed Jetson to the new main and checks
    every system with the props off: services, props interlock, camera and the
    yellow vest search, the radio link and the new STOP, the Pixhawk and the ARK
    Flow. Its prompt is written for Claude Code on the Jetson, which runs the safe
    checks and hands every sudo command and physical step to the operator.
    drone/checks/check_flow.py reads whether PX4 is set up to use the ARK Flow and
    whether it really does while the drone is lifted by hand. It never arms and
    changes no parameter or flight mode. Its verdicts are plain functions, pinned
    in CI by tests/test_check_flow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
2026-11-13 Add the master prompt for setting up the yellow vest search on the Jetson
    docs/YELLOW_VEST_PROMPT.md is one prompt for Claude Code on the Jetson. It
    pulls main, checks the Jetson's setup and repairs what's missing, sets up the
    vest search on the camera page, and proves the camera locks onto the yellow
    construction vest and ignores everyone else, with recorded trials. Then it runs
    the read-only ARK Flow check, whose output gates the drone following anyone.
    Every sudo command and physical step is handed to the operator, and nothing in
    it commands the aircraft.
    It also documents an optional drop-in that starts the search at boot, and the
    vest search README and the update runbook link to it.
